wjwpoi/DaisySeedProjects/SeedFX/docs/PROCUREMENT_READINESS.md

# 单台成品：采购前复核

**当前状态：软件与数字工程可构建，采购冻结尚未完成。** 现有装配、开孔和供应商清单需要继续复核，不能把“编译/DRC 通过”视为整机装配与采购均已确认。唯一一台设备在调试验收后作为最终成品。

## 此次查出的明确问题与修正

- 电源口：旧壳体侧孔使用居中 X=33mm，而当前 Rev6 PCB 的 J1 Fabrication 外形轴线为正视 X=42.57mm，旧横向孔位相差 9.57mm。STEP、侧孔 CSV 和布局数据现已按该轴线修正；安装高度 Z=22mm 仍须依据实际器件安装栈核对。
- 音频接口标注：PCB J2 为右侧输入、J4 为左侧输出，侧孔 CSV 已修正；两孔几何尺寸相同。
- 装配 BOM：原表中的 R9-12、R21-25、R26-29 已展开为各个器件编号，增加 Quantity 列。新增检查用导出的 KiCad 网表验证编号存在、无重复、数量一致。
- XIAO 附件包络长边取 21mm、短边修正为 17.8mm。包络检查仍未覆盖供应商实际高度、焊点和线束。

## 可推进的采购工作

| 分组 | 物料/工作 | 当前状态 |
|---|---|---|
| 首轮指定型号模块 | 原厂 Daisy Seed，确认 Rev7 与焊针配置，1 个；Seeed XIAO ESP32-C3，带天线，1 个 | 架构已选定，可准备报价/采购；后续安装在同一台最终成品中 |
| 固定料号外围 | Alpha RD901F-40-15R1-B10K ×6；Bourns PEC11R-4220K-S24 ×1；Neutrik NMJ6HCD2 ×2 | 参考项目明确使用过这些料号；购买时确认完整型号、安装图与库存 |
| 屏幕、脚踏、旋钮、排针、降压板、天线 | 对应采购 BOM 中的规格 | 待具体商品/安装图确认，尤其屏幕排布、排针高度、旋钮孔径、天线外形、降压板高度 |
| 主板与无线适配板制作/装配 | Gerber、装配 BOM、贴片位置 | 数字检查通过；当前偏向自行焊接，仍需复核主板 ERC 注记与装配尺寸；局部代焊作为练习后备选 |
| 通用壳体 / 打印壳与封面 | 淘宝铝壳加孔、或加强 PETG 打印壳；贴纸封面 | 待完整装配栈、天线位置与具体壳体确认；打印壳还需承重结构复核；用户封面尚未提供 |

本轮只准备或购买一台最终成品会使用的零件，不再安排第二台设备。工厂最低订单产生的余板是维修备件，费用全部计入该单台项目。

## 下单前尚需关闭的设计与采购事项

1. **完整装配核对**：为选定的 Seed/排针、插座、屏幕、脚踏和外壳补齐安装尺寸，检查高度、公差、USB 接入口、螺母、线束与 RF 天线。当前 CAD 只检查裸板与附件包络，主控深度≤28mm 是采购假设，尚未以完整元件模型证实。
2. **主板 ERC 注记复核**：报告中有 115 个网格警告、9 个 NC 注记与实际连接不符、1 个悬空线端。其中 A1 的 USART1 TX/RX 现在用于无线，图纸上的 NC 语义需要更新。DRC 与网表一致性通过可以证明铜层连接一致，不能替代对图纸意图的复核。
3. **电源选型与装配方式**：明确具体 Mini-360 商品的尺寸、输入/输出额定条件与调节固定方法。用户没有工具，按 [手焊方案](DIY_BUILD_OPTIONS.md) 计入基础工具与练习耗材；练习后仍可选择只代焊主板贴片。电压、纹波、噪声、过冲和温升在同一台设备组装时实测。
4. **单台完整报价**：当前全手焊加通用铝壳/外包开孔预算 ¥833.9–1801.5，全手焊加打印壳预算 ¥778.9–1636.5，均含新购工具；[逐项委托制作预估](PURCHASING_PRICES.md) 留作历史对照。实际物料最低包装、裸板订单、工具与外壳制作尚未取得完整成交报价；具体壳体安装和打印受力结构也未完成验证。

## 采购后正常进行的实机工作

在这一台设备上测量音质、端到端延迟、回调峰值、换模静音窗口、供电/RF 噪声、保存恢复和长期稳定性，按 VALIDATION.md 记录。确认后的采购尺寸与同一台设备的实际装配复核应在最终加工外壳之前完成。
