wjwpoi/DaisySeedProjects/SeedFX/mechanical/front-drill.csv

Reference | X_mm_from_left | Y_mm_from_top | Through_diameter_mm | Label
POT1 | 13 | 17 | 7.2 | INPUT
POT2 | 33 | 17 | 7.2 | BASS
POT3 | 53 | 17 | 7.2 | MID
POT4 | 13 | 40.5 | 7.2 | TREBLE
POT5 | 33 | 40.5 | 7.2 | LEVEL
POT6 | 53 | 40.5 | 7.2 | USER
ENC1 | 33 | 81.275 | 7.2 | EDIT
LED1 | 15 | 87.5 | 3.2 | ON
LED2 | 51 | 87.5 | 3.2 | CLIP
FS1 | 15 | 106.5 | 12.2 | BYPASS / TUNER
FS2 | 51 | 106.5 | 12.2 | TAP / PRESET
