wjwpoi/DaisySeedProjects/SeedFX/mechanical/accessory-placement.csv

name | x | y | z | width | length | height
radio_adapter | 5 | 55.5 | 29.699999999999996 | 32 | 28 | 7.6
xiao_esp32c3 | 38.5 | 55.5 | 34.3 | 21 | 17.8 | 4
mini360 | 39.5 | 76 | 34.3 | 18 | 14 | 4
