wjwpoi/DaisySeedProjects/SeedFX/docs/images/panel-preview.png

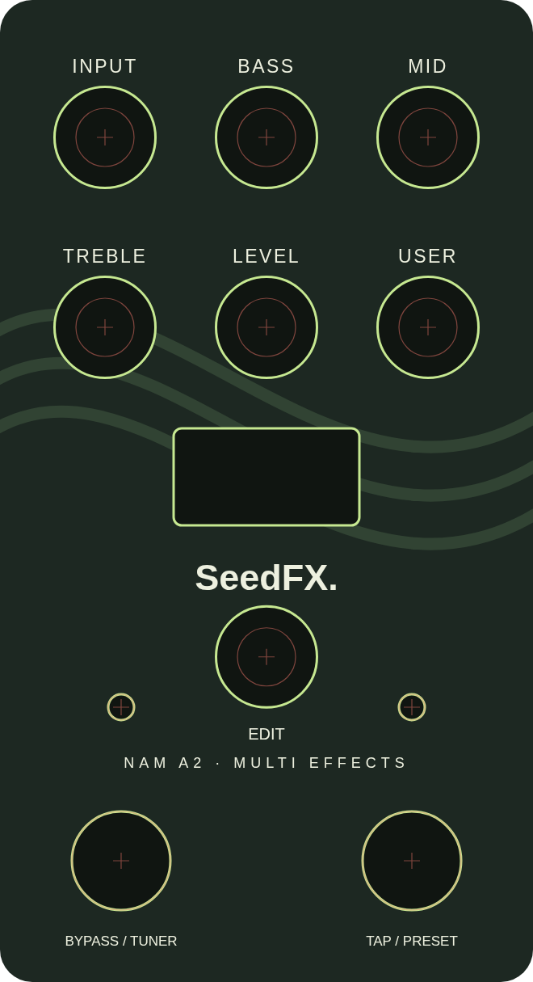
SeedFX/docs/images/panel-preview.png
