wjwpoi/DaisySeedProjects/SeedFX/docs/images/web-desktop.png

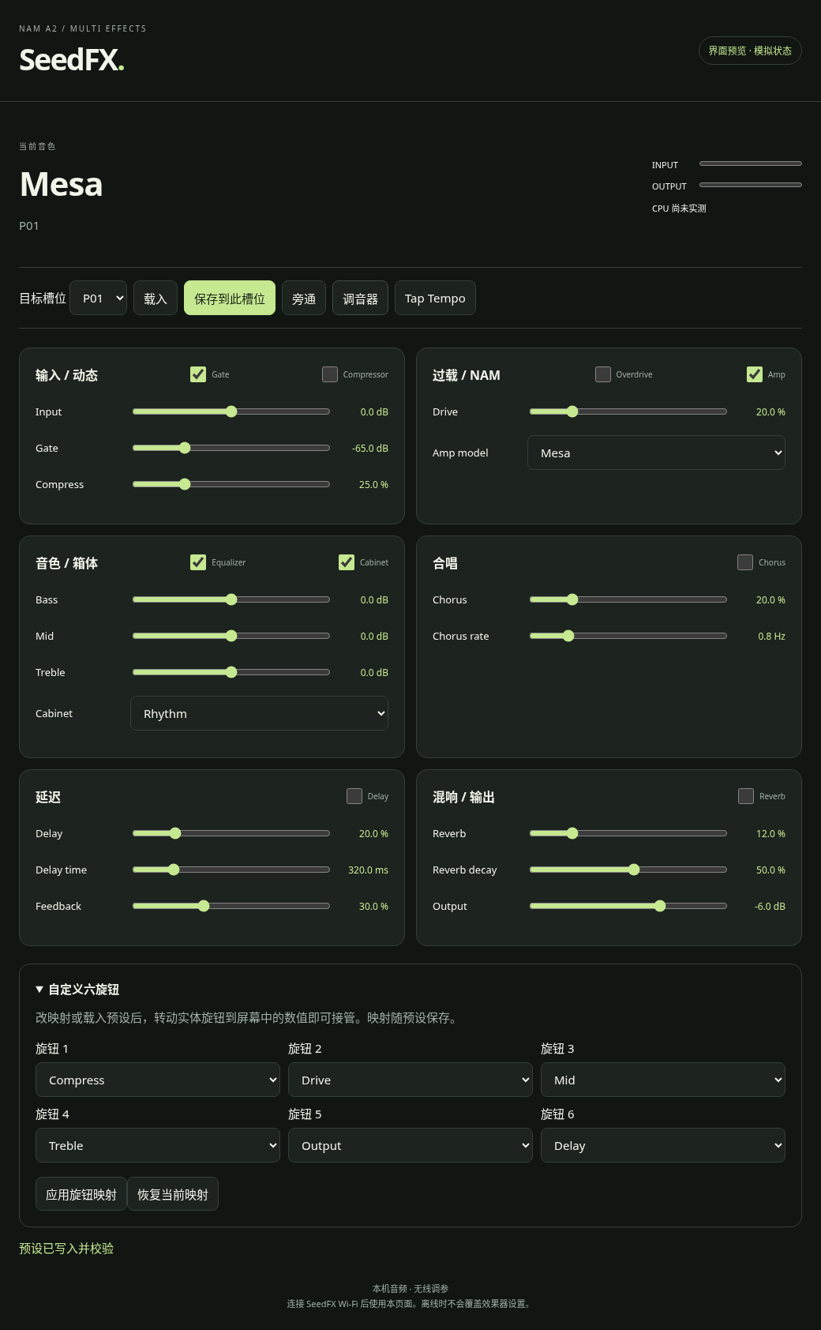
SeedFX/docs/images/web-desktop.png
