wjwpoi/DaisySeedProjects/SeedFX/docs/images/web-mobile.png

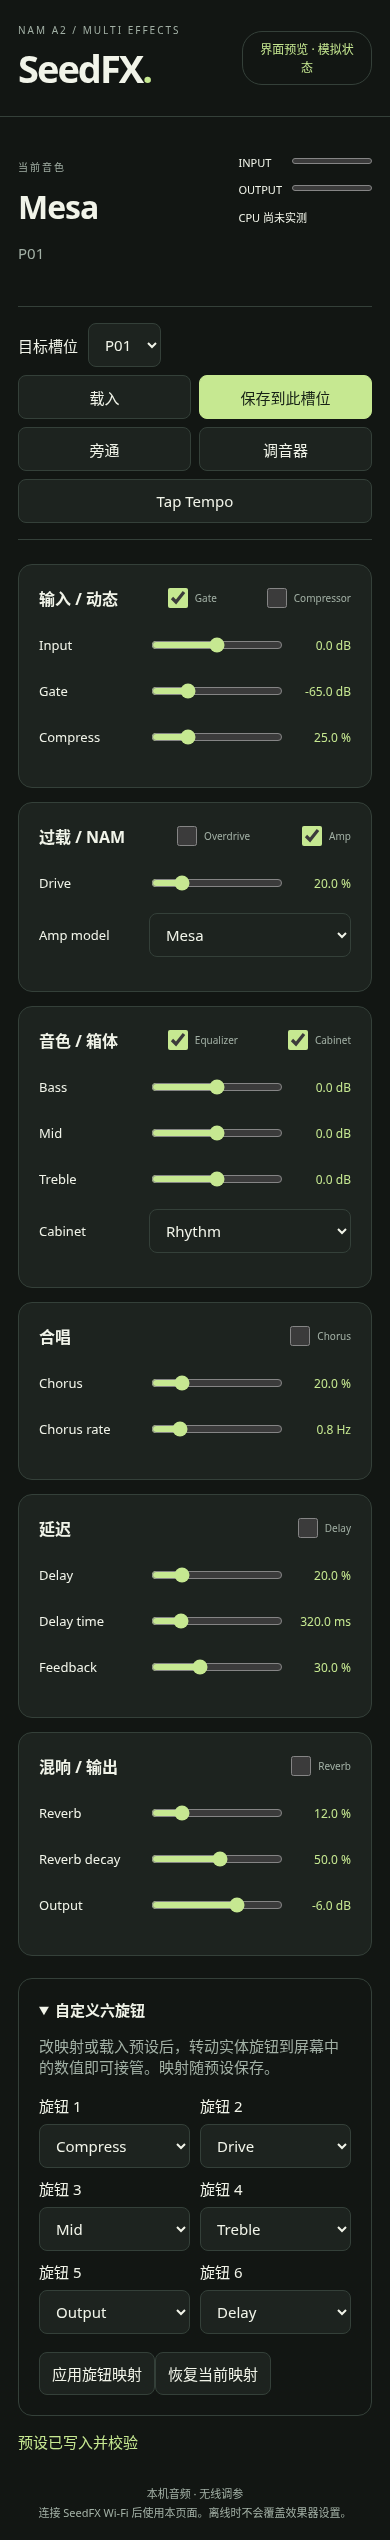
SeedFX/docs/images/web-mobile.png
