wjwpoi/DaisySeedProjects/ToneDock/docs/images/desktop.png

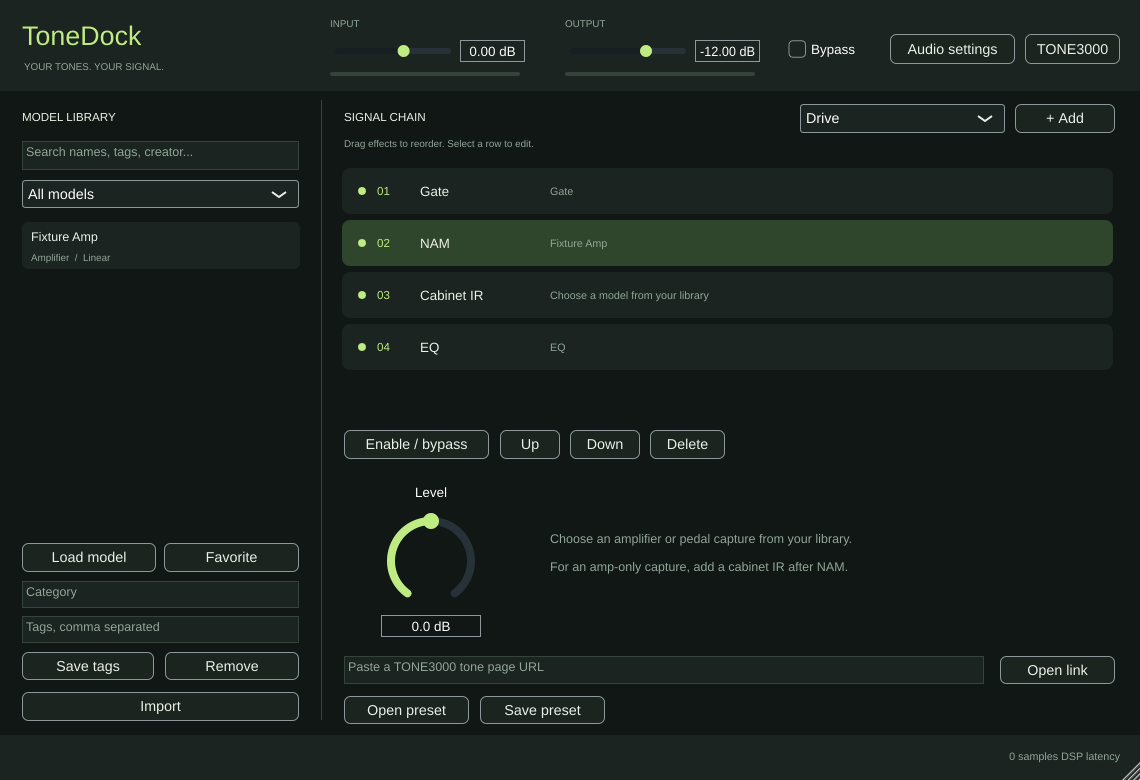
ToneDock/docs/images/desktop.png
