wjwpoi/DaisySeedProjects/SeedFX/docs/PURCHASING_PRICES.md

# 单台采购预估价

金额为人民币工程预算预估，未获取实时店铺价格或服务商报价。采购数量为一台成品所需；裸板按一次最低订单预留费用，余板作为备件。实际最低订单、装配数量和服务费需要询价确认。

**当前制作方向改为自行焊接、通用铝壳或3D打印壳，并计入从零购置工具的费用。** 下表保留此前委托制作的对照报价口径；不应把全表与新路线叠加购买。新路线见 [手焊与通用外壳预算](DIY_BUILD_OPTIONS.md)。

| 项目 | 渠道 | 数量 | 单价预估（元） | 小计预估（元） |
|---|---|---:|---:|---:|
| Daisy Seed 主控 | 淘宝 / 京东 / 原厂代理 | 1个 | 240–360 | 240–360 |
| 主板裸板最低订单 | 嘉立创打板 | 1单 | 20–60 | 20–60 |
| 主板贴片元件一套 | 嘉立创代采 / 立创商城 | 1套 | 65–120 | 65–120 |
| B10K 电位器 | 淘宝 / 立创商城 | 6个 | 4–8 | 24–48 |
| 按压编码器 | 淘宝 / 立创商城 | 1个 | 10–25 | 10–25 |
| 七针 SPI OLED | 淘宝 / 京东 | 1个 | 20–45 | 20–45 |
| Neutrik 音频插座 | 淘宝 / 立创商城 | 2个 | 10–20 | 20–40 |
| 瞬时常开脚踏 | 淘宝 / 立创商城 | 2个 | 8–18 | 16–36 |
| 3mm LED | 淘宝 / 立创商城 | 2个 | 0.2–1 | 0.4–2 |
| 旋钮帽 | 淘宝 / 立创商城 | 7个 | 2–5 | 14–35 |
| Seed 1×20 排母 | 淘宝 / 立创商城 | 2个 | 2–5 | 4–10 |
| XIAO ESP32-C3 含天线 | 淘宝 / 京东 / 原厂代理 | 1个 | 25–50 | 25–50 |
| Mini-360 降压模块 | 淘宝 / 立创商城 | 1个 | 5–15 | 5–15 |
| 适配板裸板最低订单 | 嘉立创打板 | 1单 | 10–30 | 10–30 |
| 适配板六颗贴片元件 | 立创商城 | 1套 | 3–8 | 3–8 |
| 适配板排针 | 淘宝 / 立创商城 | 3个 | 0.5–1.5 | 1.5–4.5 |
| DC-005 电源座 | 淘宝 / 立创商城 | 1个 | 1–3 | 1–3 |
| 外接 9V 电源 | 淘宝 / 京东 | 1个 | 30–80 | 30–80 |
| 标准金属壳含基础涂装 | 淘宝壳体店 | 1个 | 45–90 | 45–90 |
| RF窗口 / 托盘 / 增高圈 | 3D打印服务 | 1套 | 20–60 | 20–60 |
| 单台封面印刷 | UV印刷 / UV DTF服务 | 1次 | 25–60 | 25–60 |
| 线束 / 螺丝 / 绝缘小件 | 淘宝 / 立创商城 | 1套 | 10–25 | 10–25 |

材料与裸板订单预算合计：**¥608.9–1206.5**。

| 服务项目 | 次数 | 小计预估（元） |
|---|---:|---:|
| 主板 SMT / 代焊工费 | 1次 | 100–300 |
| 适配板手工 / 代焊工费 | 1块 | 10–30 |
| 主板通孔件焊接与线束装配 | 1台 | 50–150 |
| 外壳开孔 / 开槽 / RF窗口加工 | 1台 | 60–180 |
| 多平台合计运费 | 1项目 | 20–60 |
| 小料最小包装 / 采购补差 | 1项目 | 0–80 |

服务与采购附加预算合计：**¥240–800**。
按委托焊接、现成壳体加工路线，单台整项目预算约 **¥848.9–2006.5**。这不是供应商已确认的成交报价或价格上限。

- 主板贴片元件费与贴装工费分开，电源座、音频插座和 Seed 排母单独列价。如果工厂报价已包含它们，从网购清单中删除对应项。
- 适配板裸板、六颗贴片件、三个排针及焊接服务分开，避免打板和小料混计。
- 若代焊报价已经包含通孔件和线束装配，合并工费；自行焊接可去掉对应人工额度，工具采购不在本预算内。
- 主板材料按一个安装套数估算；SMT平台若要求多装板，需要按其整单数量重算费用。
- 小料最小包装补差与裸板最低订单分别核算；目前没有把起步费分摊给第二台机器。
- 单台封面印刷预算为一次UV印刷或UV DTF转印，不同时计算两种工艺。
- 外壳开孔、RF窗口、模块安装尺寸及所有待确认料号仍按 [采购前复核](PROCUREMENT_READINESS.md) 关闭后下单。

明细：[材料 CSV](../hardware/purchase-bom.csv)、[服务 CSV](../hardware/service-budget.csv)、[机器预算](../hardware/cost-plan.json)。

相对原仓库的新增与沿用费用见 [成本来源对比](COST_COMPARISON.md)。当前分项外包预算不能作为原作者造价或商家报价。
