wjwpoi/DaisySeedProjects/SeedFX/hardware/mainboard/assembly-bom.csv

Comment | Designator | Footprint | LCSC_part | Populate_SeedFX | Quantity
10uF | C1,C11,C12,C15,C16,C4,C7,C8 | 805 | C15850 | yes | 8
100nF | C13,C14,C2,C3,C5,C6 | 805 | C49678 | yes | 6
100nF | C17 | 805 | C49678 | DNP | 1
2.2nF | C10,C9 | 805 | C28260 | yes | 2
10nF | C18,C19 | 805 | C1710 | yes | 2
1N5817 | D1 | SOD-123 | C727113 | yes | 1
1N4148W | D2 | SOD-123 | C81598 | DNP | 1
1N4007W | D3,D4 | SOD-123FL | C108803 | yes | 2
DC-005-2.5A-2.0 | J1 |  | C136744 | yes | 1
NMJ6HCD2 | J2,J4 |  | C368502 | yes | 2
PJ-320A | J3,J5 |  | C2884926 | DNP | 2
1x20 Through Hole Header | J6,J7 |  | C50984 | yes | 2
G6K-2G-Y DC5 | K1,K2 | SMD,6.5x10mm | C397140 | yes | 2
SS8050 | Q1 | SOT-23-3 | C2150 | yes | 1
2M | R1,R10,R11,R12,R15,R16,R2,R4,R5,R9 | 805 | C26112 | yes | 10
100K | R3,R6 | 805 | C149504 | yes | 2
100R | R13,R14 | 805 | C17408 | yes | 2
220R | R17 | 805 | C17557 | DNP | 1
33R | R19 | 805 | C17634 | DNP | 1
10R | R18 | 805 | C17415 | DNP | 1
470R | R20 | 805 | C17710 | DNP | 1
1K | R21,R22,R23,R24,R25 | 805 | C17513 | yes | 5
3.3K | R7,R8 | 805 | C26010 | yes | 2
10K | R26,R27,R28,R29 | 805 | C17414 | yes | 4
LD1117S50CTR | U1 | SOT-223-3 | C81157 | yes | 1
MCP6004T-I/SL | U2 | SOIC-14 | C7378 | yes | 1
OPA1652AIDR | U3 | SOIC-8 | C30025 | yes | 1
H11L1 | U4 | SOP-6-2.54mm | C78589 | DNP | 1
CPC1018N | U5,U6 | SOP-4-2.54mm | C133069 | yes | 2
