wjwpoi/DaisySeedProjects/SeedFX/mechanical/mainboard.step

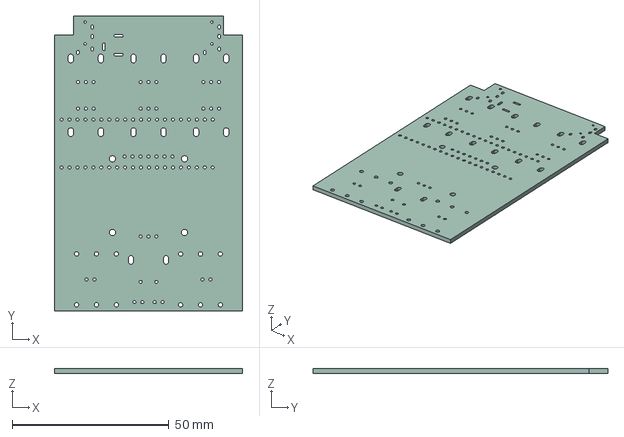
[picture p5: CAD file, 2026-10-14]
SeedFX/mechanical/mainboard.step
60.0 x 94.0 x 1.52 mm
