wjwpoi/DaisySeedProjects/SeedFX/mechanical/seedfx-case.step

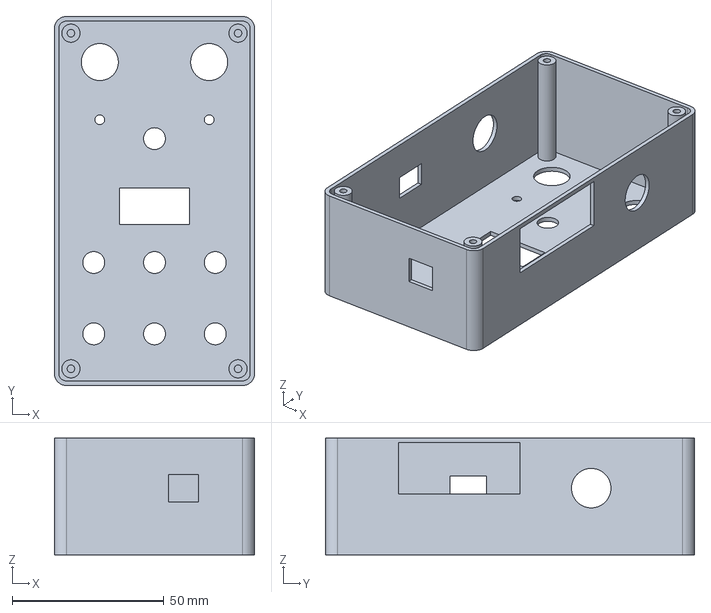
[picture p6: CAD file, 2026-10-14]
SeedFX/mechanical/seedfx-case.step
66.0 x 121.5 x 38.5 mm
