wjwpoi/DaisySeedProjects/SeedFX/mechanical/front-drill.dxf

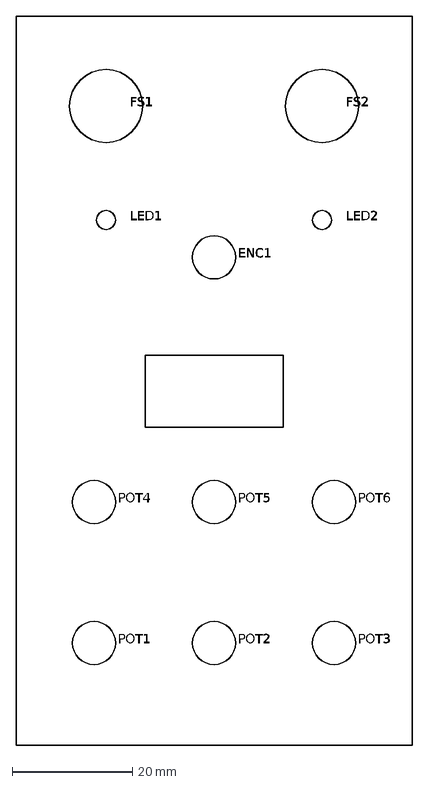
[picture p7: CAD file, 2026-10-14]
SeedFX/mechanical/front-drill.dxf
POT1
POT2
POT3
POT4
POT5
POT6
ENC1
LED1
LED2
FS1
FS2
