wjwpoi/DaisySeedProjects/SeedFX/mechanical/seedfx-insulating-tray.step

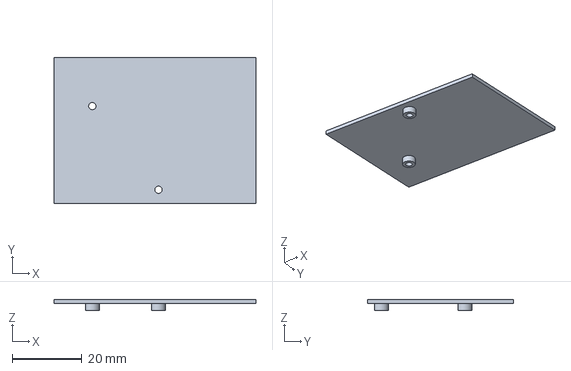
[picture p8: CAD file, 2026-10-14]
SeedFX/mechanical/seedfx-insulating-tray.step
58.0 x 42.0 x 3.20 mm
