wjwpoi/DaisySeedProjects/SeedFX/mechanical/seedfx-lid.step

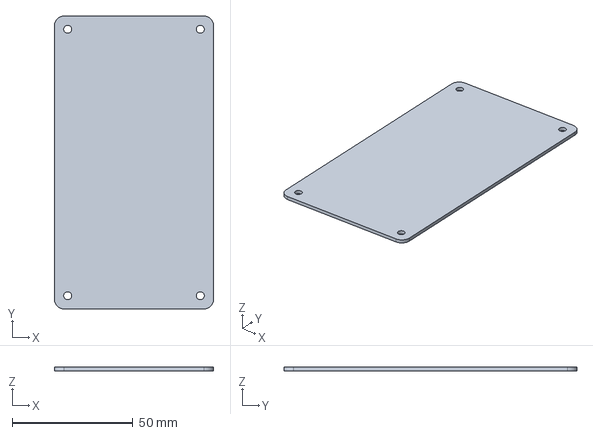
[picture p9: CAD file, 2026-10-14]
SeedFX/mechanical/seedfx-lid.step
66.0 x 121.5 x 1.50 mm
