wjwpoi/DaisySeedProjects/SeedFX/mechanical/seedfx-enclosure.step

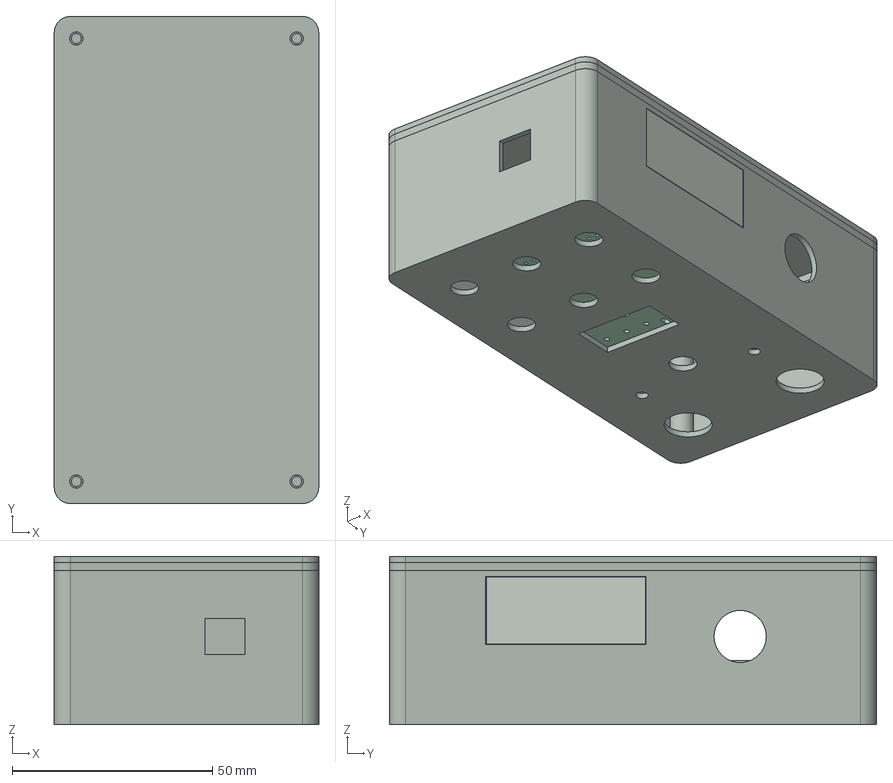
[picture p10: CAD file, 2026-10-14]
SeedFX/mechanical/seedfx-enclosure.step
66.0 x 121.5 x 42.0 mm
lid_spacer_part
insulating_tray_part
radio_window_part
case_part
lid_part
mainboard_body_part
radio_adapter_envelope_part
xiao_esp32c3_envelope_part
mini360_envelope_part
