wjwpoi/DaisySeedProjects/SeedFX/mechanical/seedfx-lid-spacer.step

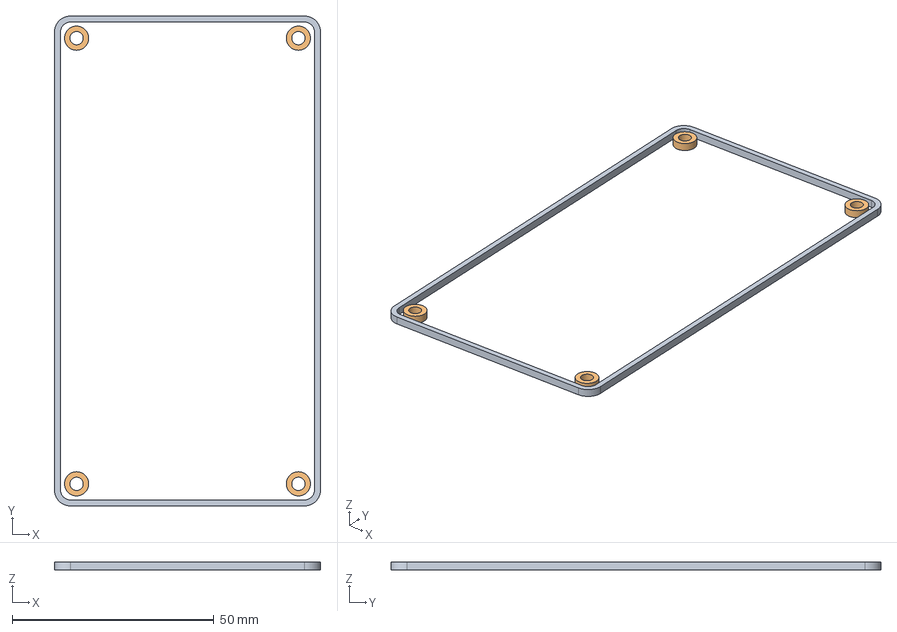
[picture p11: CAD file, 2026-10-14]
SeedFX/mechanical/seedfx-lid-spacer.step
66.0 x 121.5 x 2.00 mm
