wjwpoi/DaisySeedProjects/SeedFX/mechanical/seedfx-rf-window.step

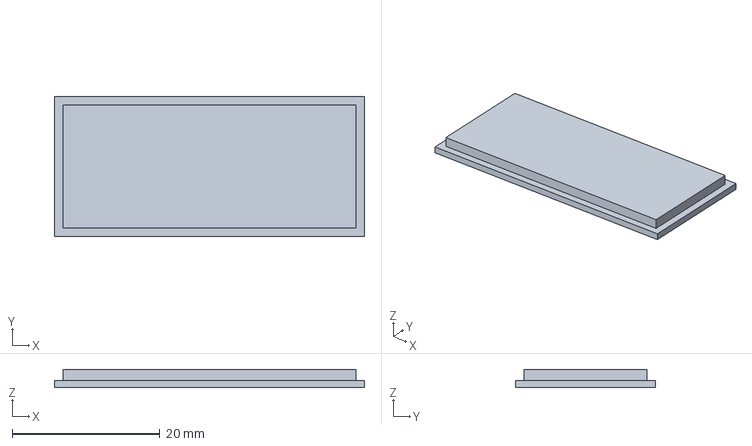
[picture p12: CAD file, 2026-10-14]
SeedFX/mechanical/seedfx-rf-window.step
42.0 x 19.0 x 2.50 mm
