wjwpoi/DaisySeedProjects/(list of files, cad)

Other CAD files:
SeedFX/mechanical/seedfx-case.stl
SeedFX/mechanical/seedfx-insulating-tray.stl
SeedFX/mechanical/seedfx-lid-spacer.stl
SeedFX/mechanical/seedfx-lid.stl
SeedFX/mechanical/seedfx-rf-window.stl
