wjwpoi/DaisySeedProjects/SeedFX/docs/VALIDATION.md

# 验证记录与实机验收

## 数字检查

当前执行结果由 `docs/validation.json` 汇总，构建产物及文件 SHA256 在发布包 manifest 中。

| 检查 | 范围与结果 |
|---|---|
| Daisy 交叉编译 | Cortex-M7、hard-float、BOOT_SRAM；ELF/HEX/BIN 生成；链接内存未溢出 |
| ESP32-C3 交叉编译 | ESP-IDF v5.4.2；网页嵌入；生成 bootloader、分区表和应用；分区容量检查通过 |
| 协议 | CRC32 标准向量、500 组随机帧、损坏拒绝、溢出恢复、SPSC 队列边界 |
| 音频与控制 | 真实 NAM 推理、五模型全效果链有限/有界输出、IR 响应与延迟回声检查、参数边界、旋钮慢速转动/拾取、配置淡出/暂停、预设 CRC 和失败恢复逻辑 |
| 快速初始化 | 原始 133 块预热对比五个模型的解析稳态；15,360 个样本，当前最大绝对误差约 8.64e-7 |
| 模型校验 | 有效固定结构；拒绝错误权重数、NaN、同数目错结构、错误激活和 44.1kHz |
| 网页逻辑 | 参数、模型整数、预设和映射范围；错误/离线请求不会报成功 |
| 浏览器 | 实际 Chromium；模型选择、多旋钮草稿、写入确认等待、调音读数、390px 布局、失联禁用；数据为明确标注的测试夹具 |
| PCB | 两块板 DRC 无违规、无未连接项、无网表一致性问题；适配板 ERC 无违规 |
| 主板 ERC | 没有错误；保留参考图纸 115 项 off-grid、9 项已连接 NC 标记和1项线端警告。主板实际铜层网表一致性与连接检查通过；报告完整保留，不以隐藏警告代替检查 |
| 机械 | 裸主板与壳体实体干涉为零；附件包络与主板/壳体/后盖及附件间无重叠；主控深度需≤28mm，附件按采购包络限制；不覆盖实际器件高度、公差和线束 |

本机运行的测试不是硬件在环测试。主机 CPU 上的耗时不能作为 STM32 的回调耗时，浏览器测试夹具不证明实物无线工作。没有执行 USB 烧录、吉他试听、模拟电路测量或 RF/温升测试。

## 唯一一台设备的成品验收表

| 项目 | 方法与判定 |
|---|---|
| 电源 | 接主控前检查极性/短路；9V 输入，标定 5V；0–0.5A 负载、开关机和瞬态检查；无越过 MCU 允许范围的电压 |
| 旋钮与数字输入 | 六 ADC 全行程、编码器两个方向/按压、两脚踏长短按；确认没有支脚碰到 Seed 针座 |
| 屏幕 | SSD1306 SPI、列/行完整、开孔不遮活动区、字号与户外可读性 |
| 音频电平 | 1kHz 已知电压信号测输入满量程与输出；确认 codec 前不过载，旁通与启用响度可控制 |
| 延迟 | 用环回录音测 NAM/EQ/IR 路径；记录首次响应和峰值/群延迟，目标小于5ms |
| 实时预算 | 所有效果、各模型、最大反馈、屏幕刷新及 Wi-Fi 连续调参；回调最大耗时低于1ms，目标留25%余量，无丢块 |
| 换模 | 五模型至少100次切换，记录静音窗口及是否有明显爆音；目标小于20ms，不能用解析初始化主机测试代替 |
| 同模型预设 | 比较声音、旋钮拾取、启停与尾音；连续参数更新不重载权重 |
| 保存与断电 | 两银行轮换；写入过程中断电后恢复旧有效或新完整银行；保留至少一个有效配置；验证重启槽位 |
| 调音 | E2–E4 六弦与单音，A4=440；目标稳定状态±5 cents，避免泛音倍频误判 |
| 无线与噪声 | 天线装入实际壳体后，5m连接与重连；Wi-Fi开/关录音对比，检查电源和RF串入的噪声 |
| 长时间运行 | 至少60分钟最坏链路，记录温升、供电电流、重连、CPU峰值及音频异常 |
| 机械 | 原料壳与实际器件核尺寸；盖合、螺母、螺柱、焊点、USB口、线束、绝缘及跌落后的固定情况 |

在这唯一一台设备上完成组装、测量、修正和验收。若实测不满足设计指标，按记录修改具体 DSP、供电、天线或结构；达到验收目标后，该设备即为最终成品。
