wjwpoi/DaisySeedProjects/ToneDock/docs/VALIDATION.md

# 验证状态

2026-10-15，北京时间。当前为开发版，**尚未标记为可发布版本**。

| 项目 | 结果 |
|---|---|
| Linux 云端原生编译 | 独立软件与 Linux VST3 构建通过 |
| 自动化测试 | 1 个套件通过，49,860 项检查，含真实编辑器操作 |
| NAM 对照 | LSTM、WaveNet、A2、A1 Standard 与固定提交的官方运行时对照，测试样本最大误差均为0 |
| 宿主采样率转换 | 44.1 / 96 kHz、1 / 17 / 64 / 257 / 511 样本缓冲检查通过 |
| 模型库 | 元数据分类、SHA去重、保存、并发写入、ZIP导入、坏文件/越界ZIP拒绝通过 |
| 实际音频处理器 | Gain → NAM → 输出增益的信号计算、宿主旁通与预设恢复通过 |
| 原生编辑器 | 旋钮、添加、旁通、上移、拖拽、删除检查通过；保存实际组件截图 |
| 独立软件启动 | Xvfb内启动、生成原生编辑器PNG、正常退出通过 |
| 云环境复用脚本 | 安装/配置、重复执行、构建和测试通过 |
| macOS开发归档 | 真实macOS流水线完成归档与上传；Linux夹具的解压检查确认可执行权限和符号链接得到保留 |
| AU注册等待脚本 | 模拟工具检查：延迟发现、超时、仅执行一次完整校验、校验错误退出码保留；不替代真实AU结果 |
| Windows | `4283c77` 独立软件/VST3原生构建、核心测试和开发包上传通过；真实DAW与声卡验收未执行 |
| macOS | `4283c77` Universal独立软件/VST3/AU构建、核心测试、完整AU校验和开发包上传通过；执行环境为macos-14 arm64，Intel运行验收未执行 |
| TONE3000 真实账号 | 未执行；依据官方接入代码完成适配，实际公钥、浏览器授权和下载待联调 |
| 声卡 / DAW 实测 | 未执行；不以云端DSP检查承诺实际端到端延迟或最低可用缓冲 |
| 发行安装包 / 发行签名 / 公证 | 未执行 |

截图 [desktop.png](images/desktop.png) 来自实际JUCE编辑器与自行生成的 Linear 测试模型，不是TONE3000在线浏览或真实音色试听。模型对照只证明这些测试输入与同版本运行时一致，不代表所有架构/模型、所有系统均完成兼容性验收。

结构变化会重建图并交叉淡化，效果尾音不保证完整延续；模型计算量和短时双图渲染仍可能超过特定设备CPU预算。每个效果的完整宿主自动化、第三方插件承载和移动端不在本版范围。

机器记录见 [validation.json](validation.json)，原始输出见 [核心测试](validation/core-tests.log) 与 [独立软件运行日志](validation/standalone.log)。

原生检查与开发包下载见 [GitHub Actions](https://github.com/wjwpoi/DaisySeedProjects/actions/runs/38723754252)。Windows与macOS均完成该轮检查；这些结果不代替真实DAW、声卡或账号联调。

AU安装后先签名验证并刷新注册服务，等待系统枚举出 `aufx / Tnd1 / Tndk` 后，再执行一次完整 `auval -v aufx Tnd1 Tndk`；超时和校验错误均保留为失败。首轮的名称读取、版本 `-50` 与组件未找到错误发生于发现阶段；加入注册就绪等待的用户目录版本已实际通过。最终工作流与该成功版本一致。
