wjwpoi/DaisySeedProjects/SeedFX/hardware/manufacturing/mainboard/schematic.pdf

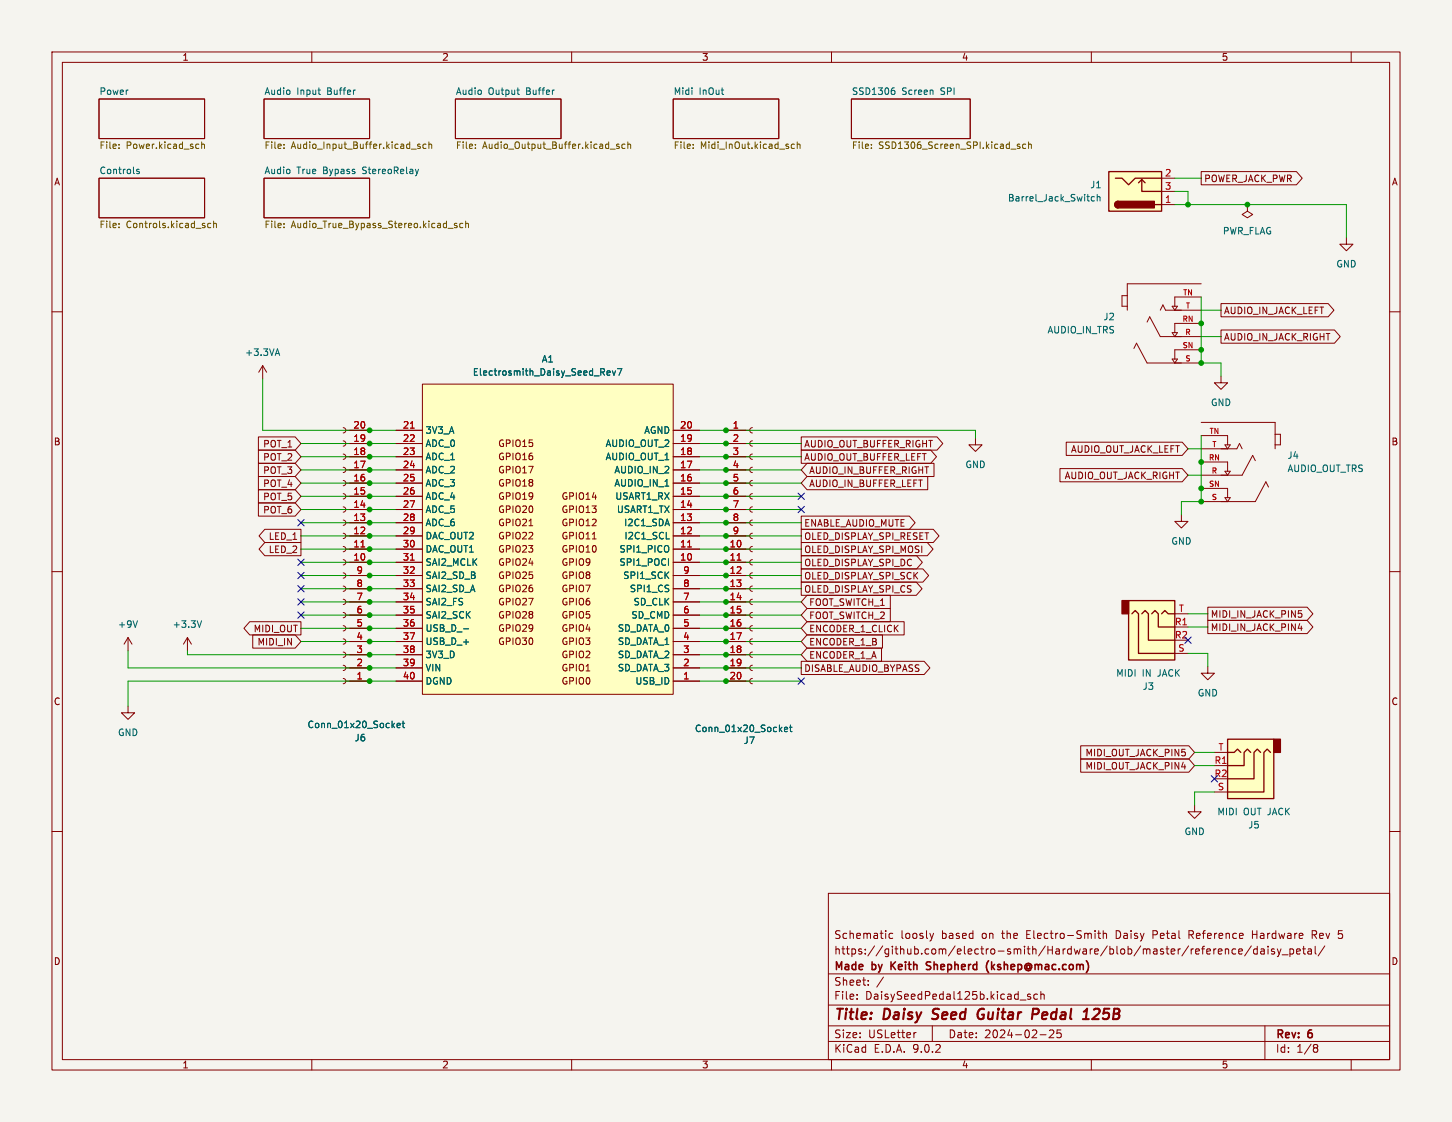
[picture p13: page 1]

Id: 1/8 Title: Daisy Seed Guitar Pedal 125B

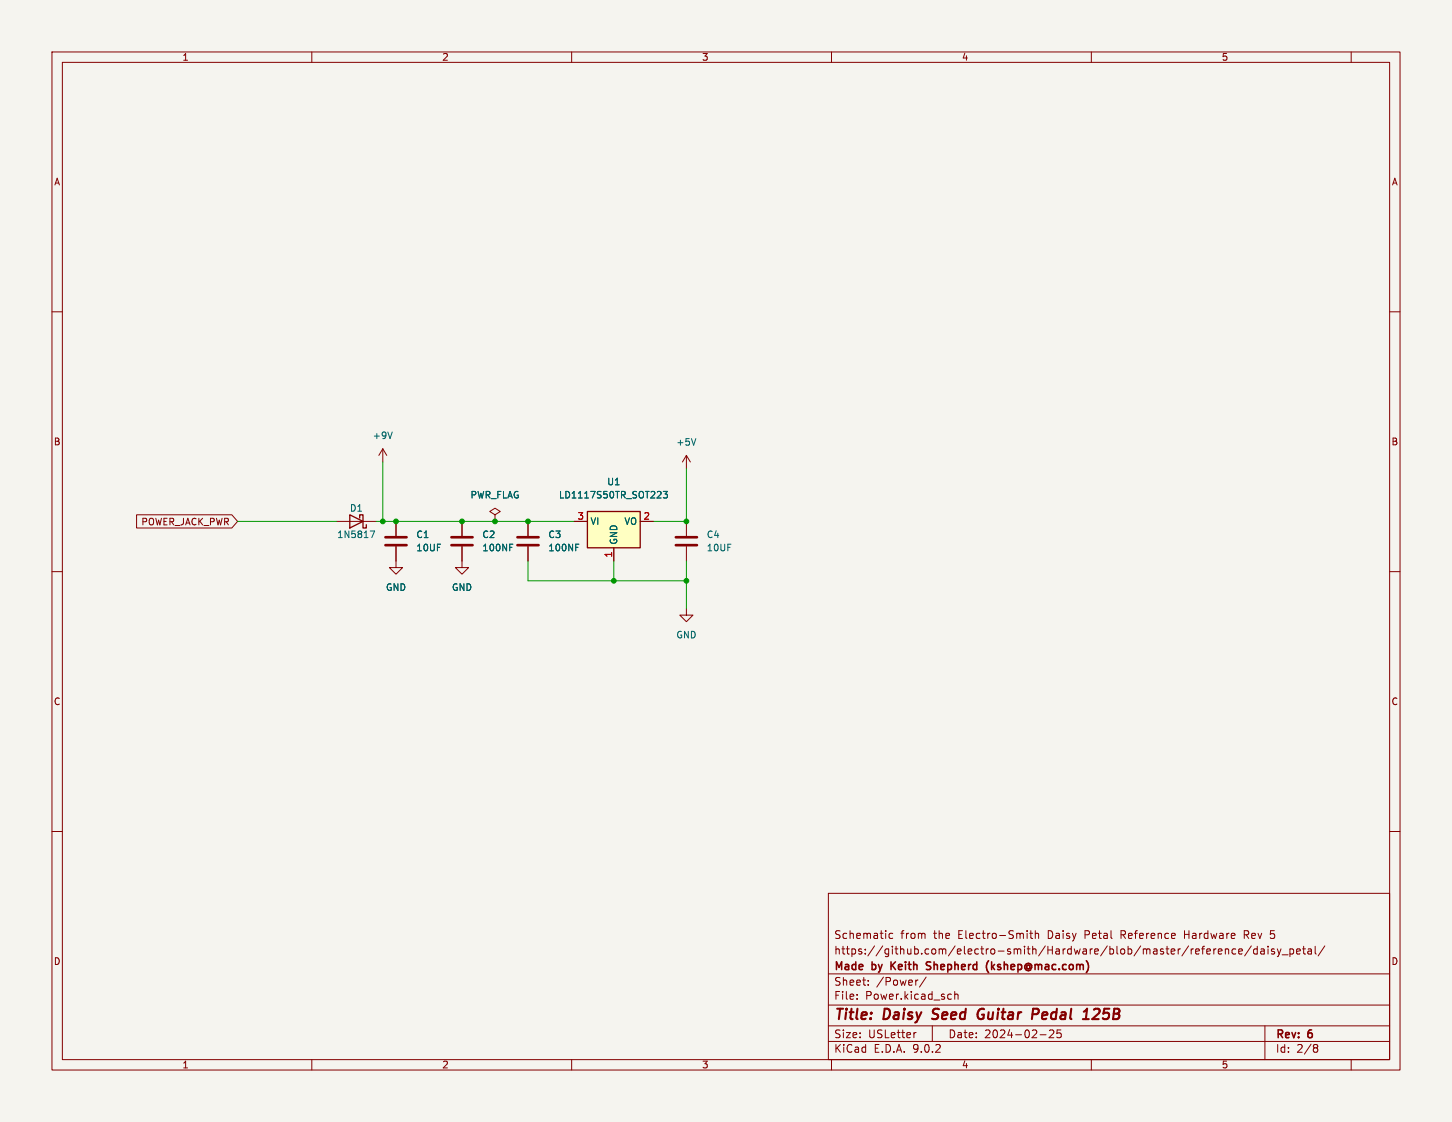
[picture p14: page 2]

Id: 2/8 Title: Daisy Seed Guitar Pedal 125B

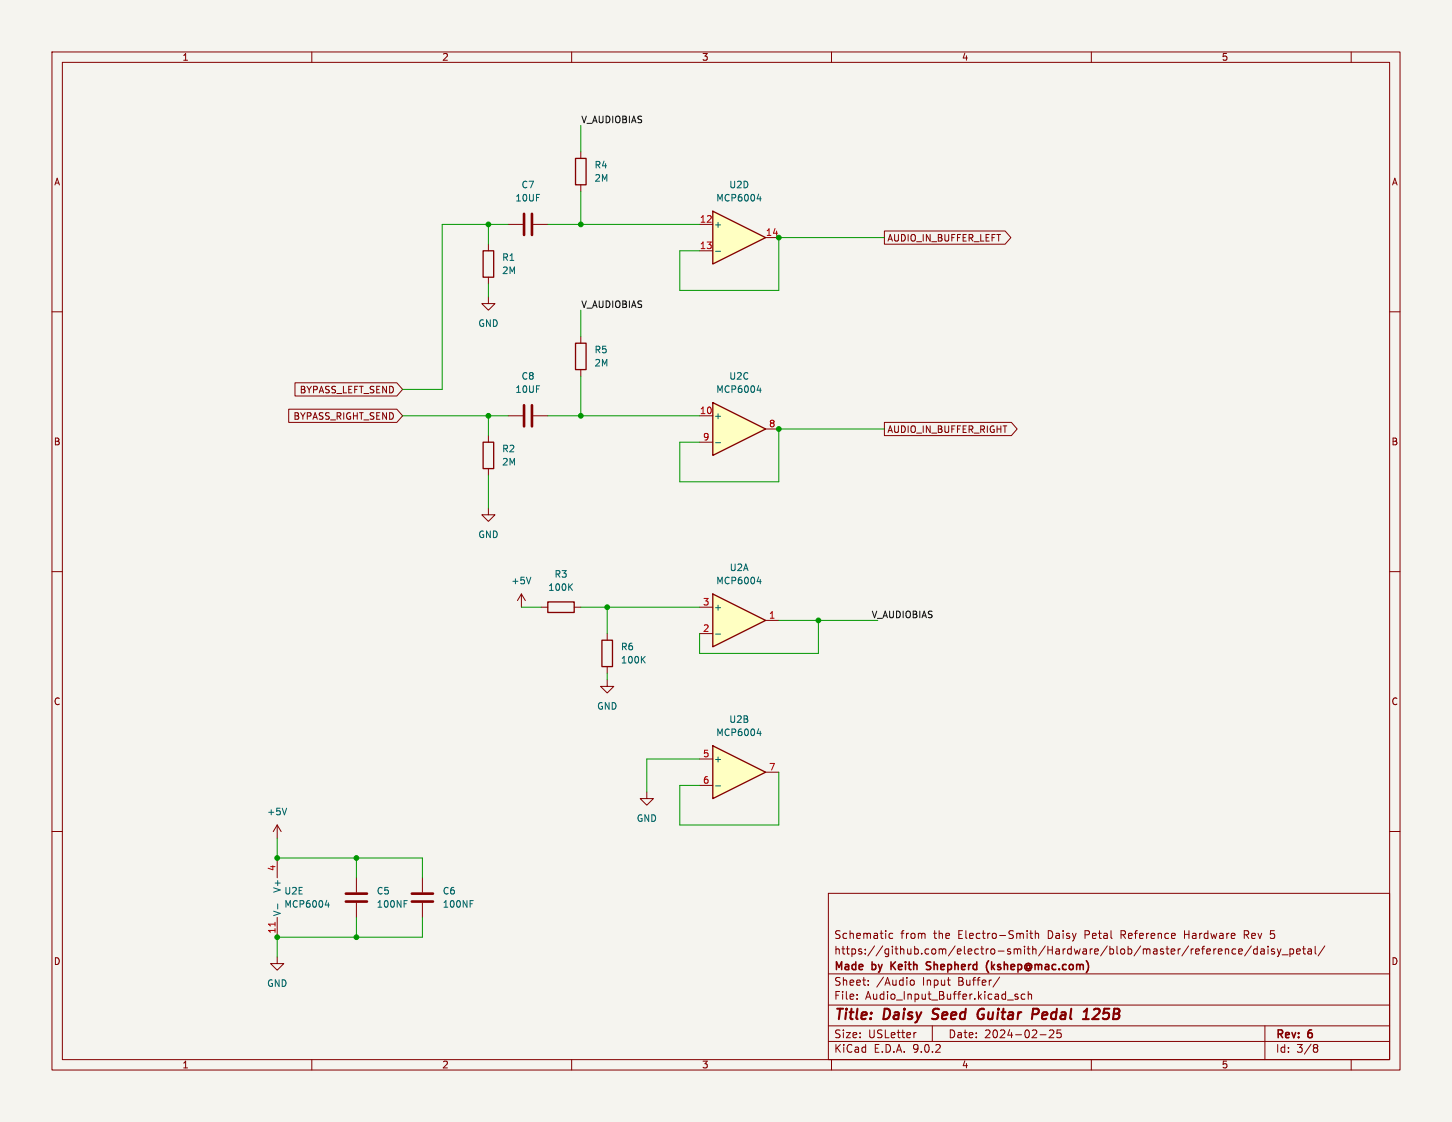
[picture p15: page 3]

Id: 3/8 Title: Daisy Seed Guitar Pedal 125B

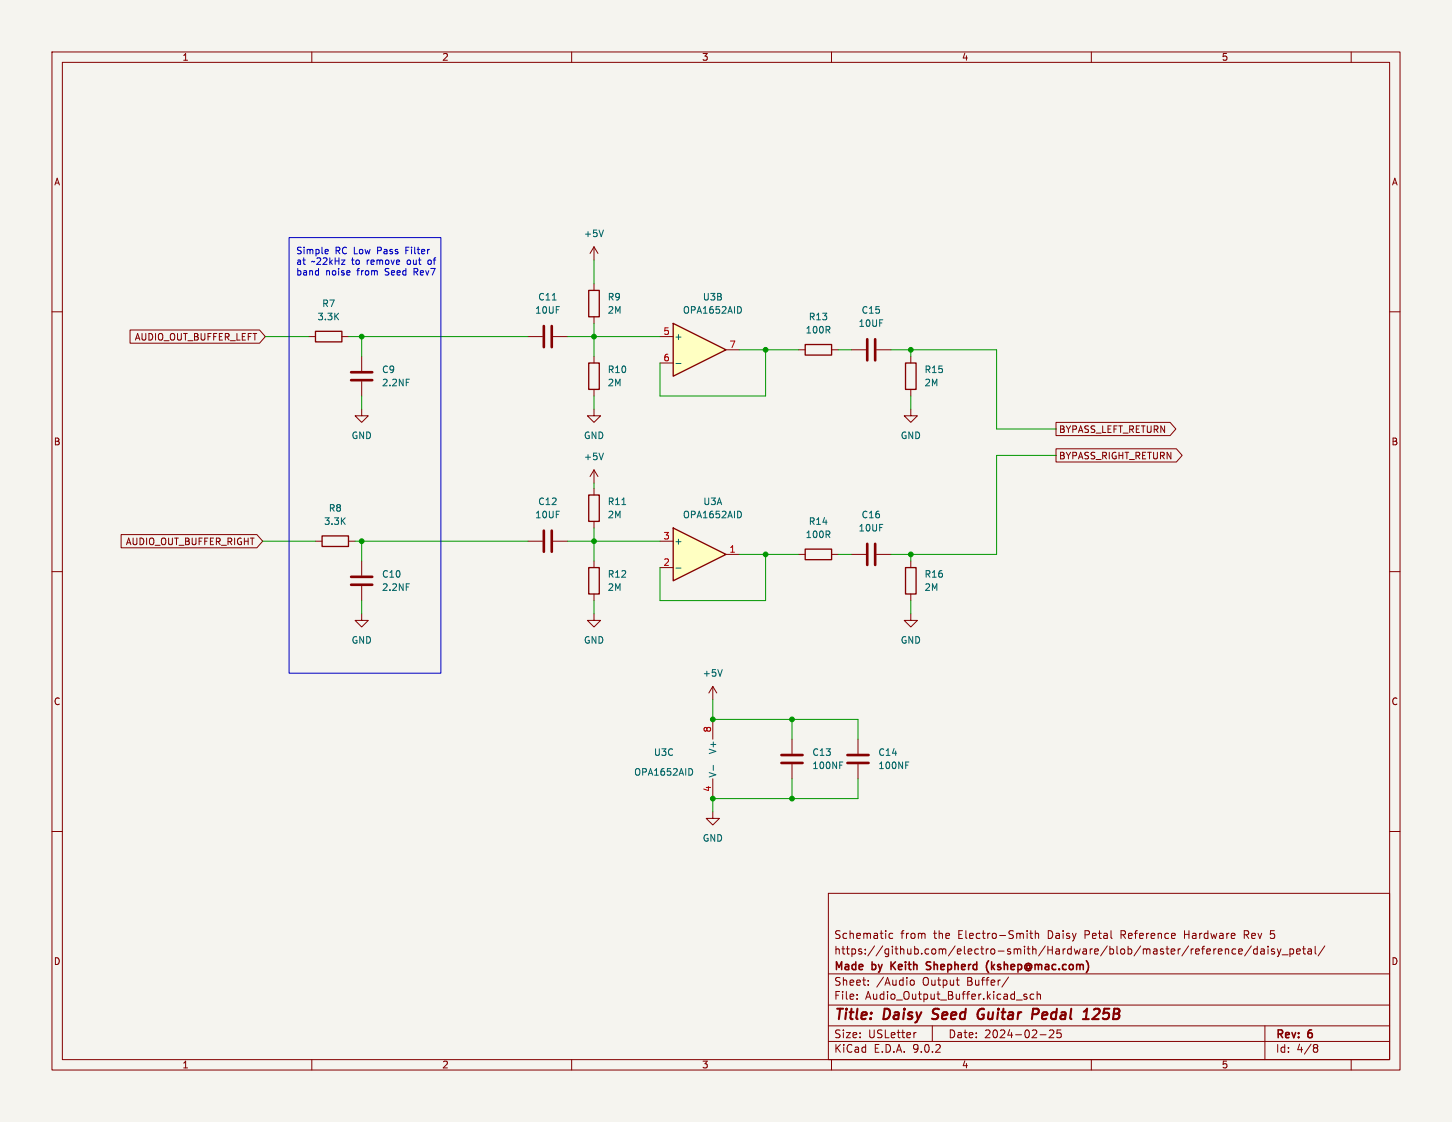
[picture p16: page 4]

https://github.com/electro-smith/Hardware/blob/master/reference/daisy_petal/ Schematic | from the | | Electro-Smith | Daisy | Petal | Reference | Hardware | Rev 5

E.D.A. 9.0.2 Size: USLetter | Rev: 6 | D Date: 2024-02-25 KiCad

Id: 4/8 Title: Daisy Seed Guitar Pedal 125B

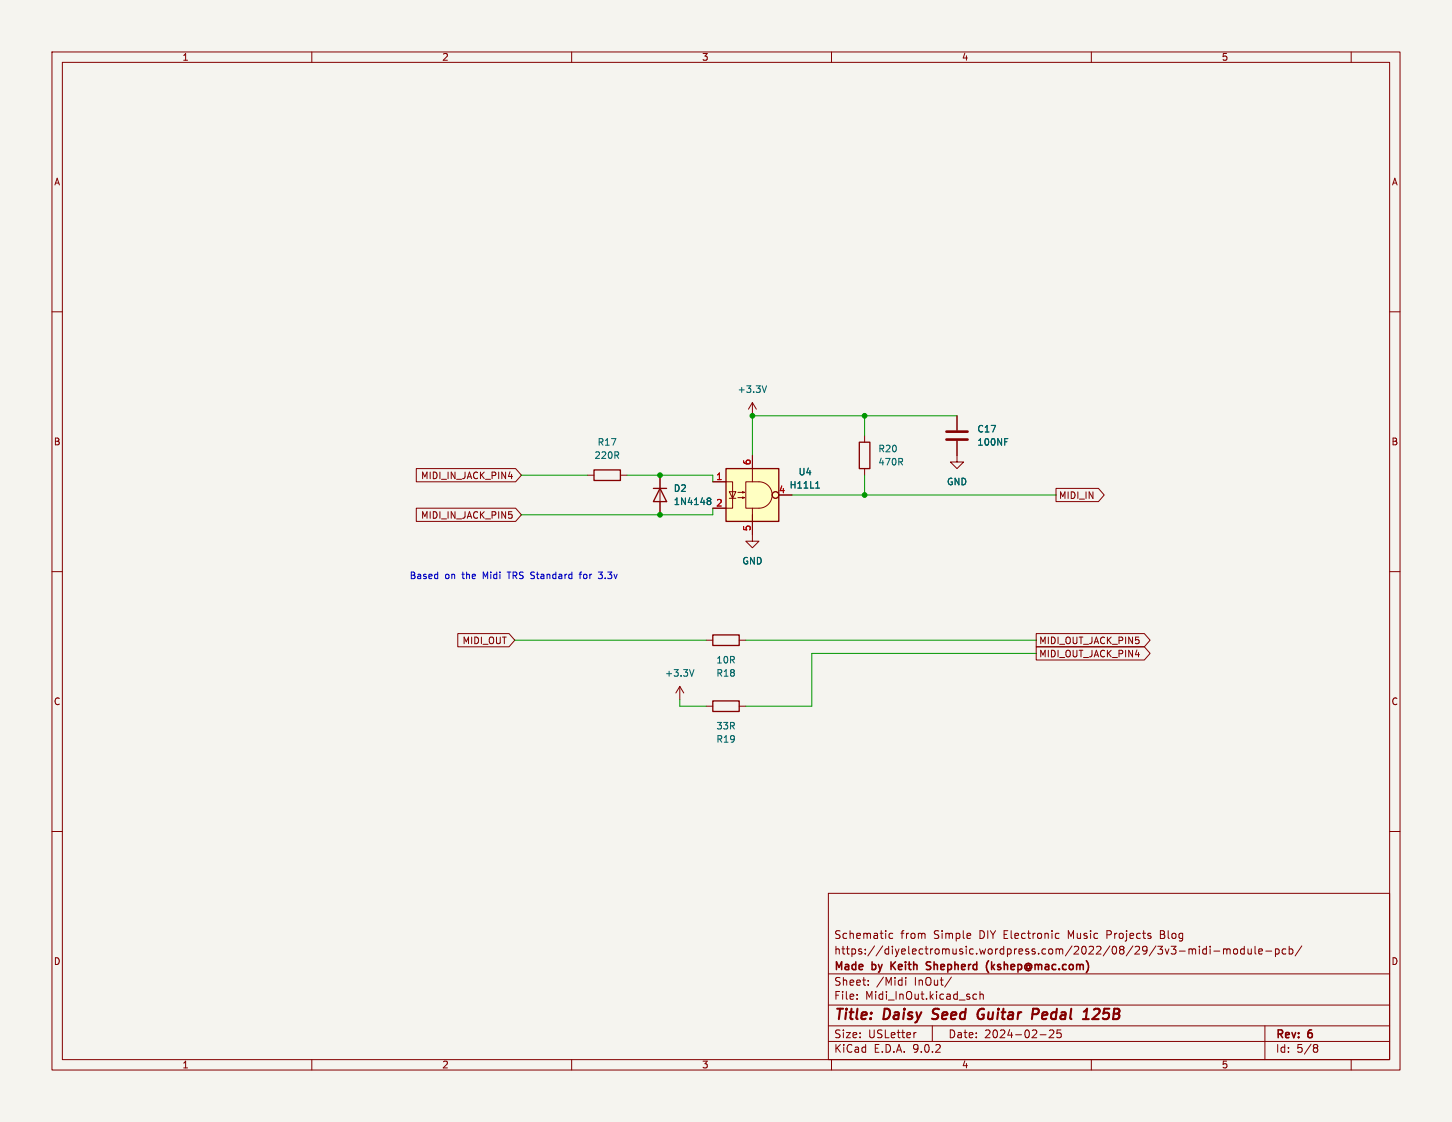
[picture p17: page 5]

Id: 5/8 Title: Daisy Seed Guitar Pedal 125B

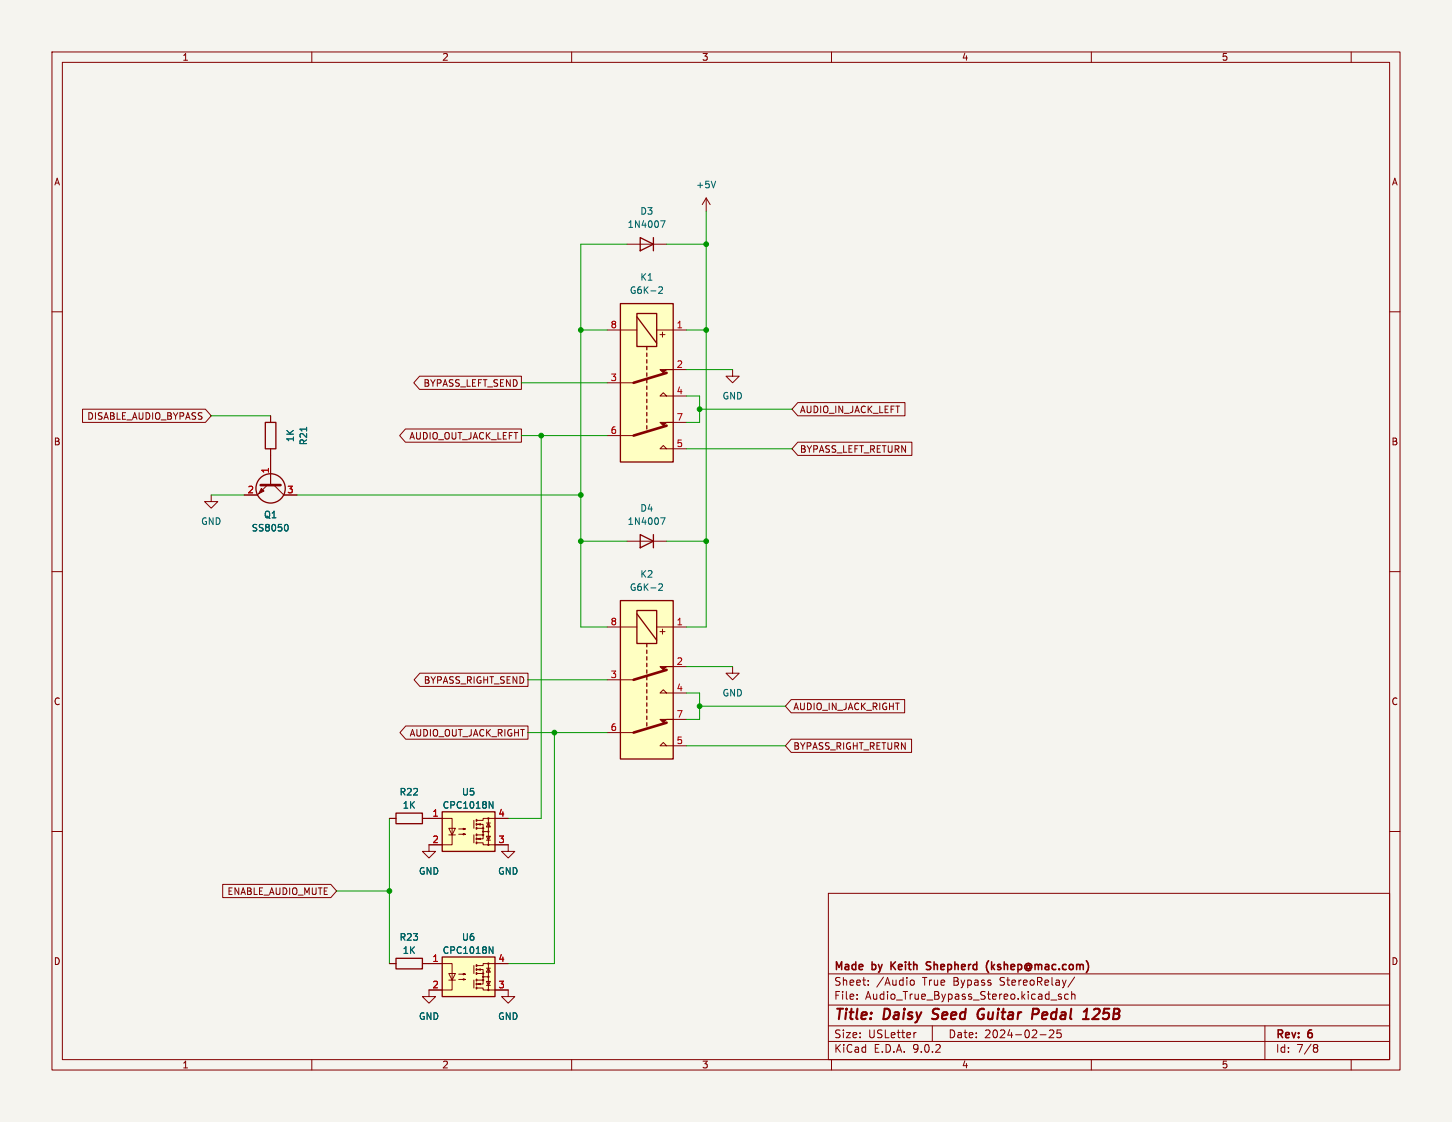
[picture p18: page 6]

Id: 7/8 Title: Daisy Seed Guitar Pedal 125B

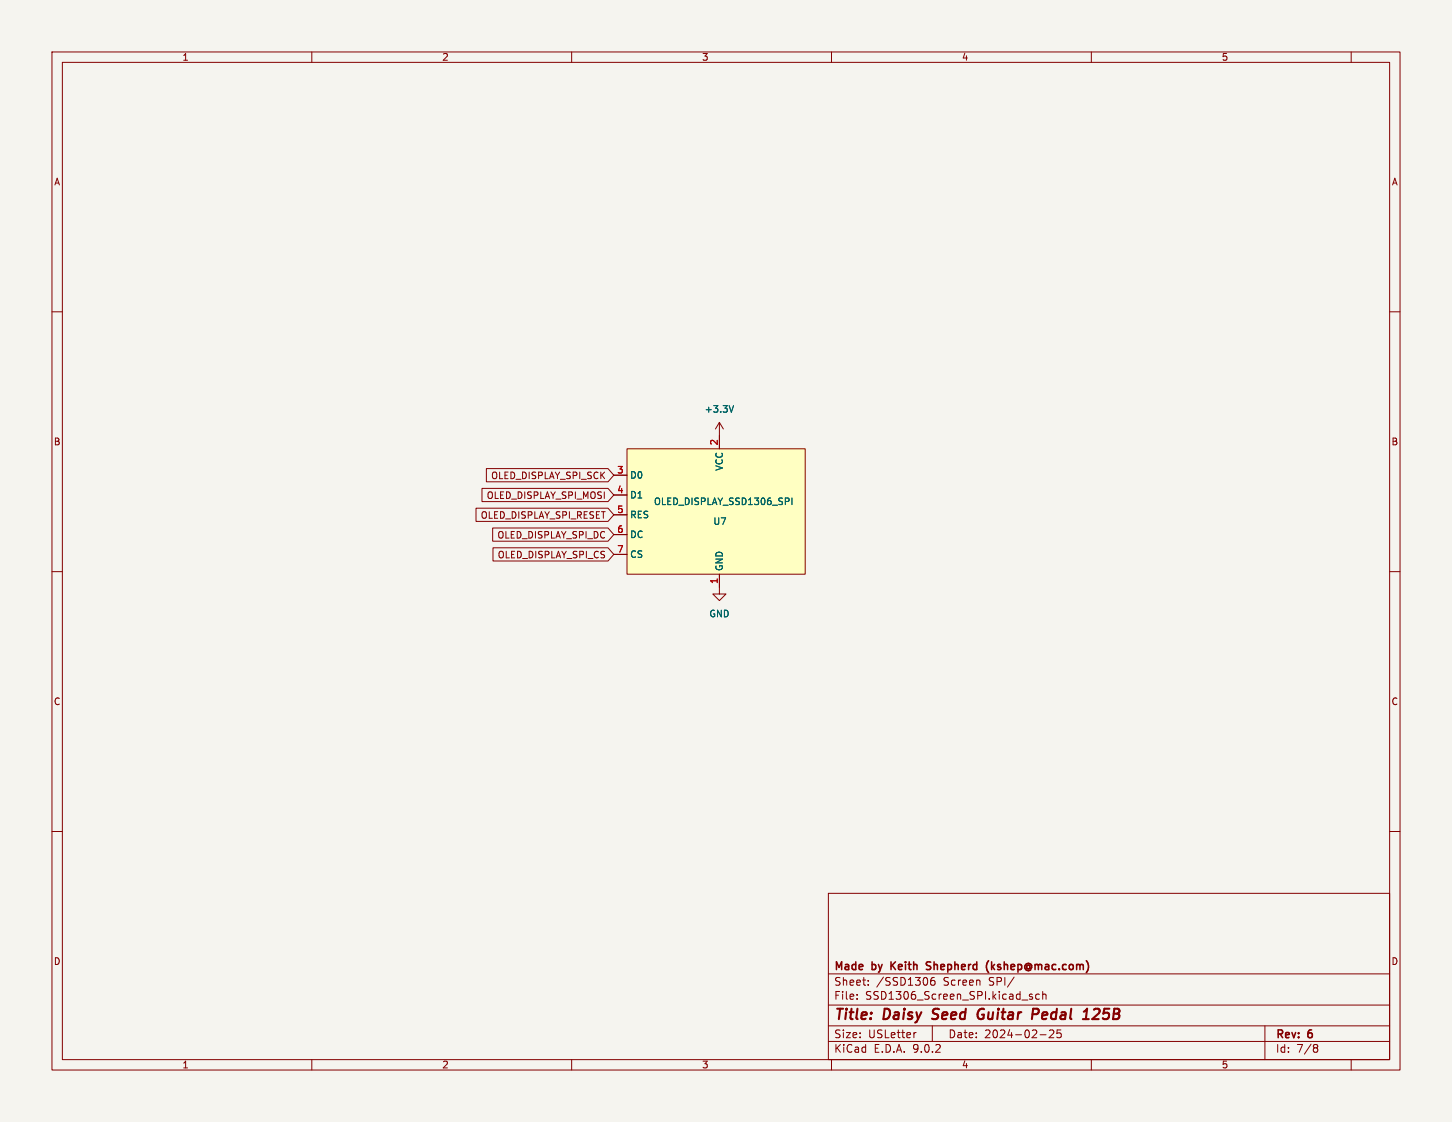
[picture p19: page 7]

Id: 7/8 Title: Daisy Seed Guitar Pedal 125B

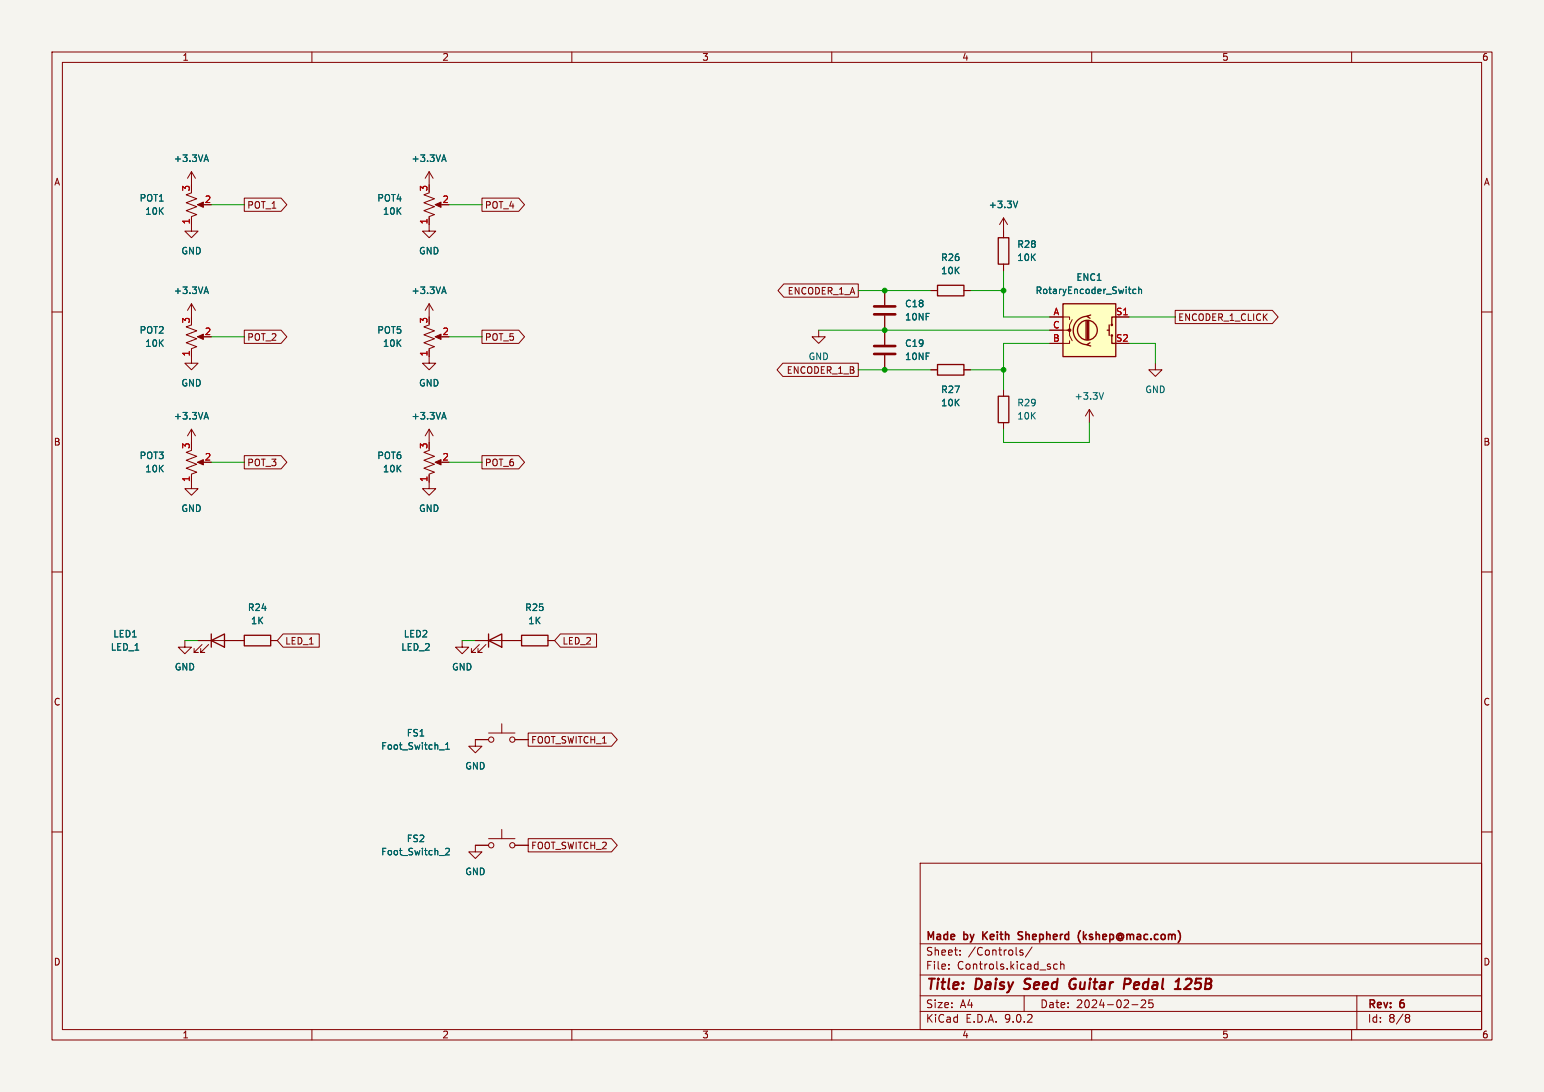
[picture p20: page 8]

Id: 8/8 Title: Daisy Seed Guitar Pedal 125B
