wjwpoi/DaisySeedProjects/SeedFX/hardware/manufacturing/adapter/assembly.pdf

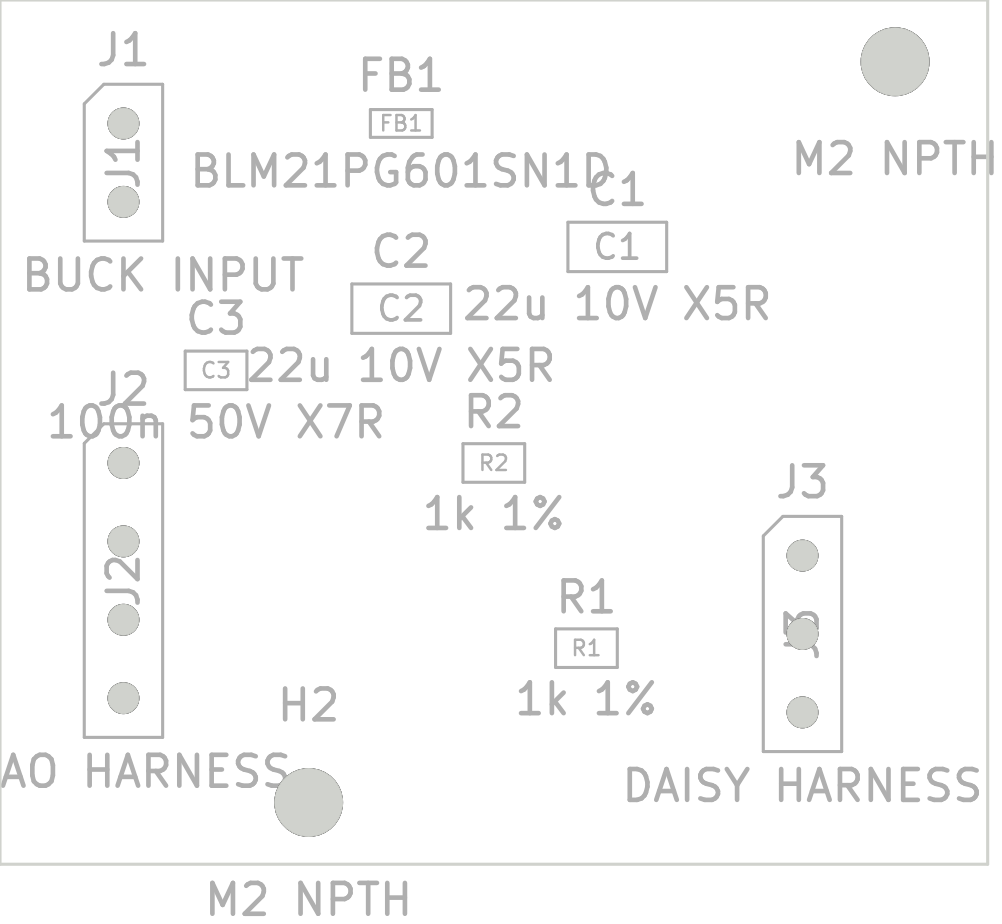
[picture p21: page 1]
