wjwpoi/DaisySeedProjects/SeedFX/hardware/manufacturing/adapter/schematic.pdf

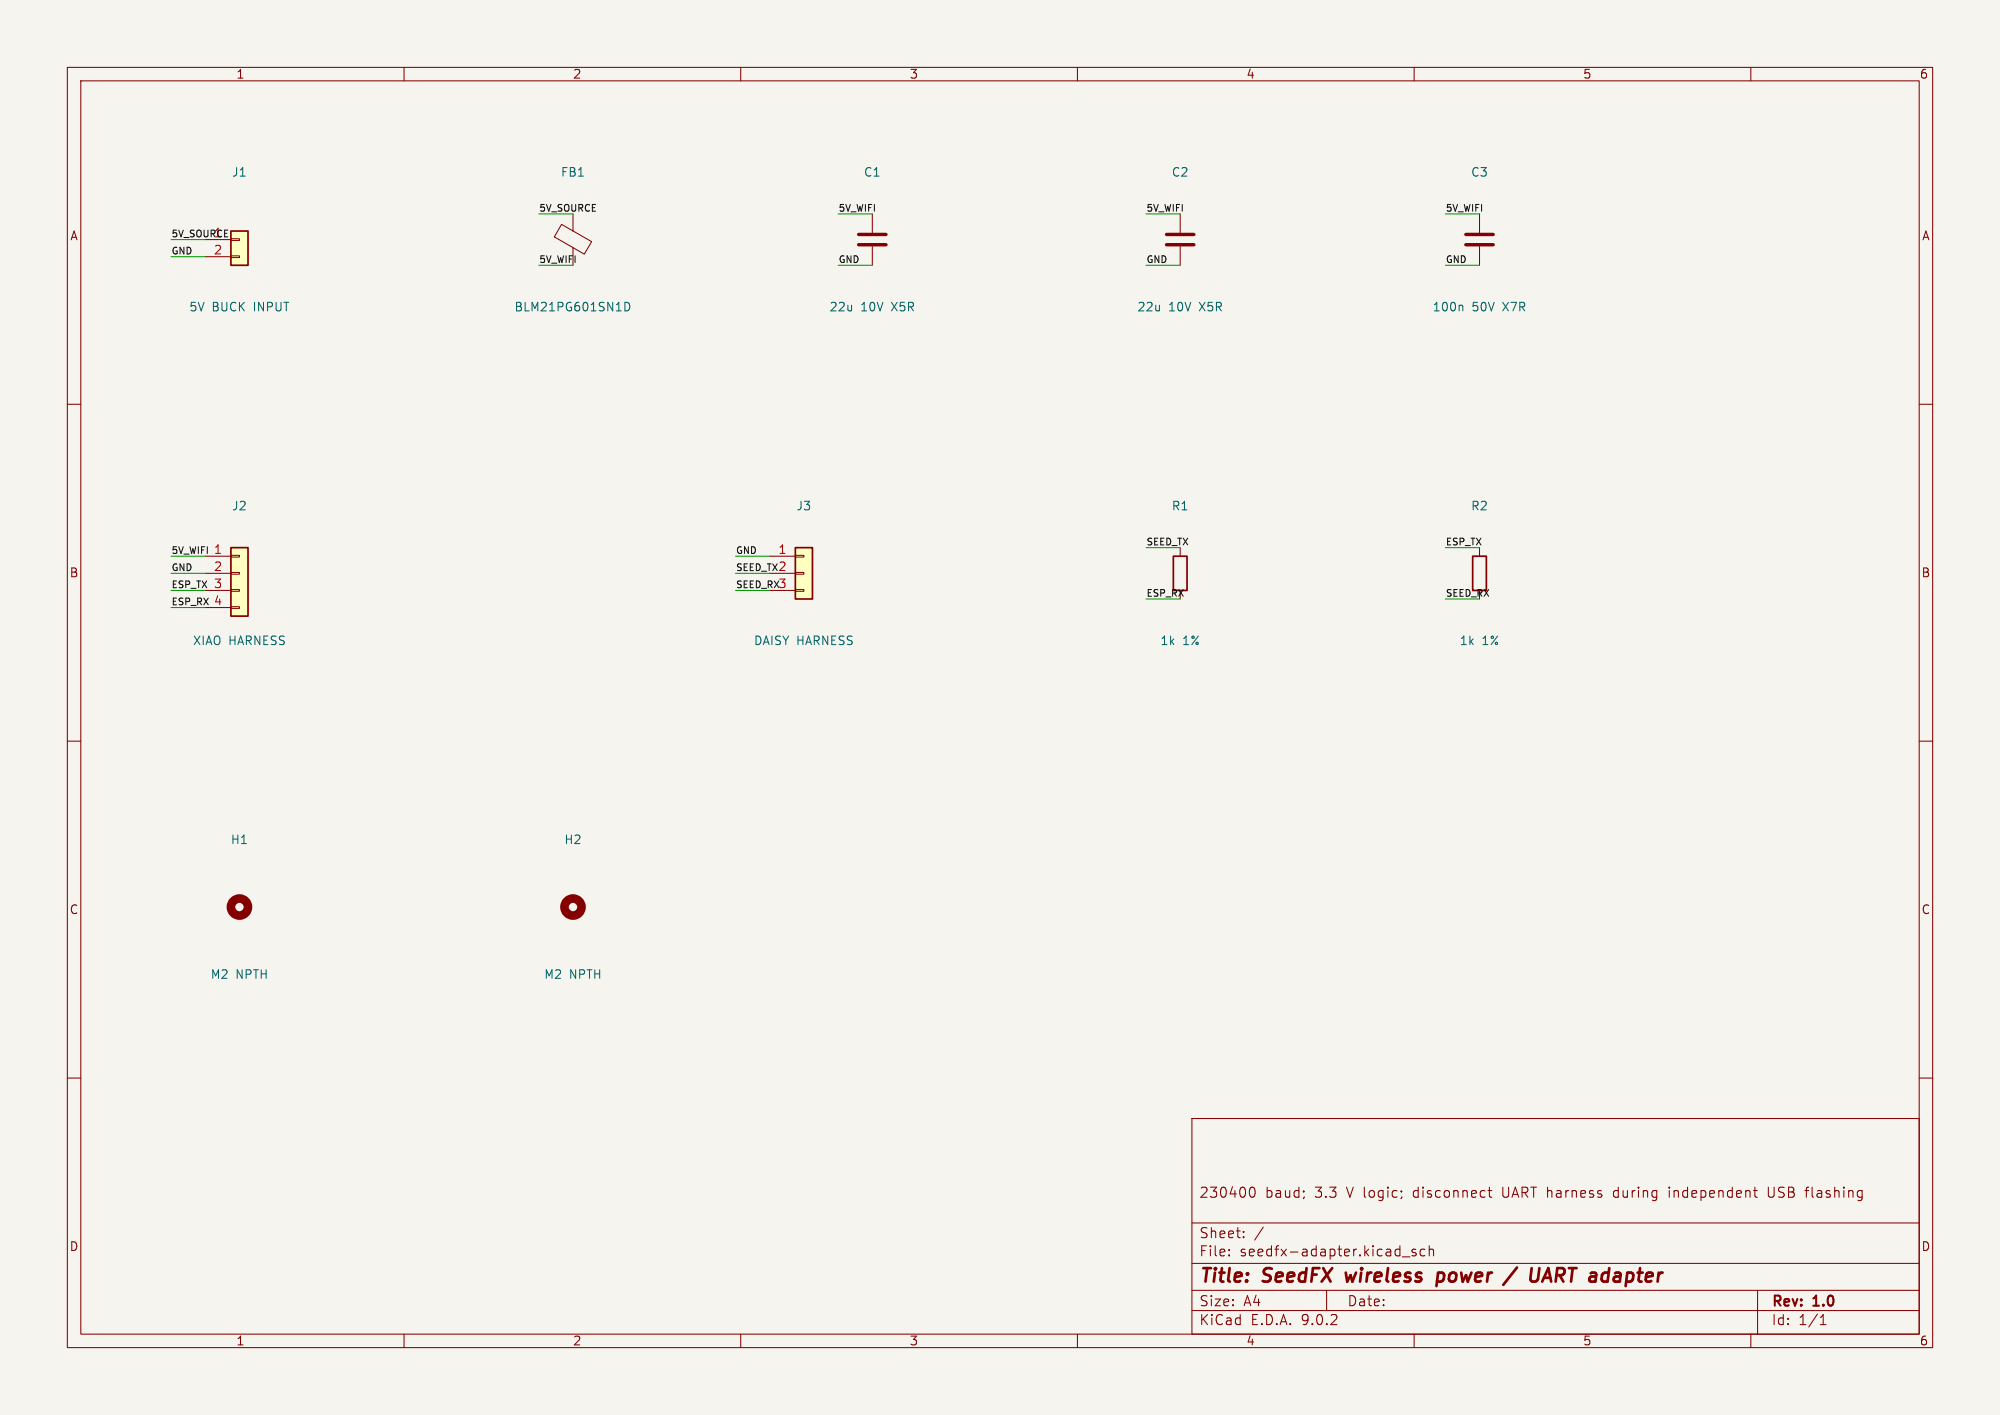
[picture p22: page 1]
