wjwpoi/DaisySeedProjects/SeedFX/hardware/manufacturing/mainboard/assembly.pdf

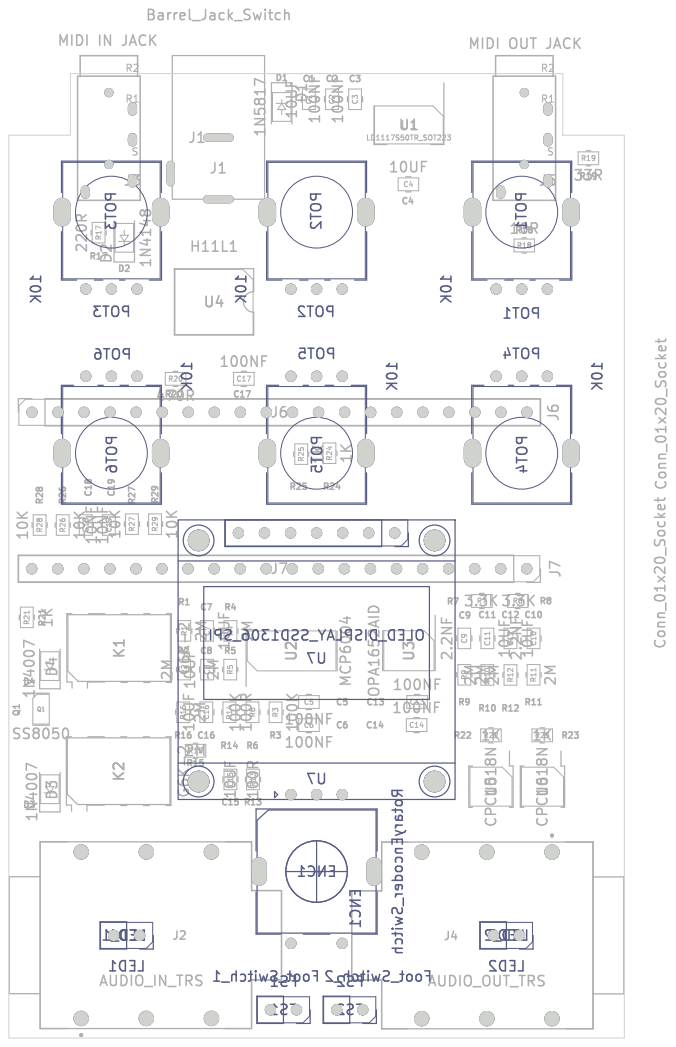
[picture p23: page 1]
