wjwpoi/DaisySeedProjects/SeedFX/hardware/adapter/seedfx-adapter.kicad_pcb

## KiCad design SeedFX/hardware/adapter/seedfx-adapter.kicad_pcb (2026-10-14)

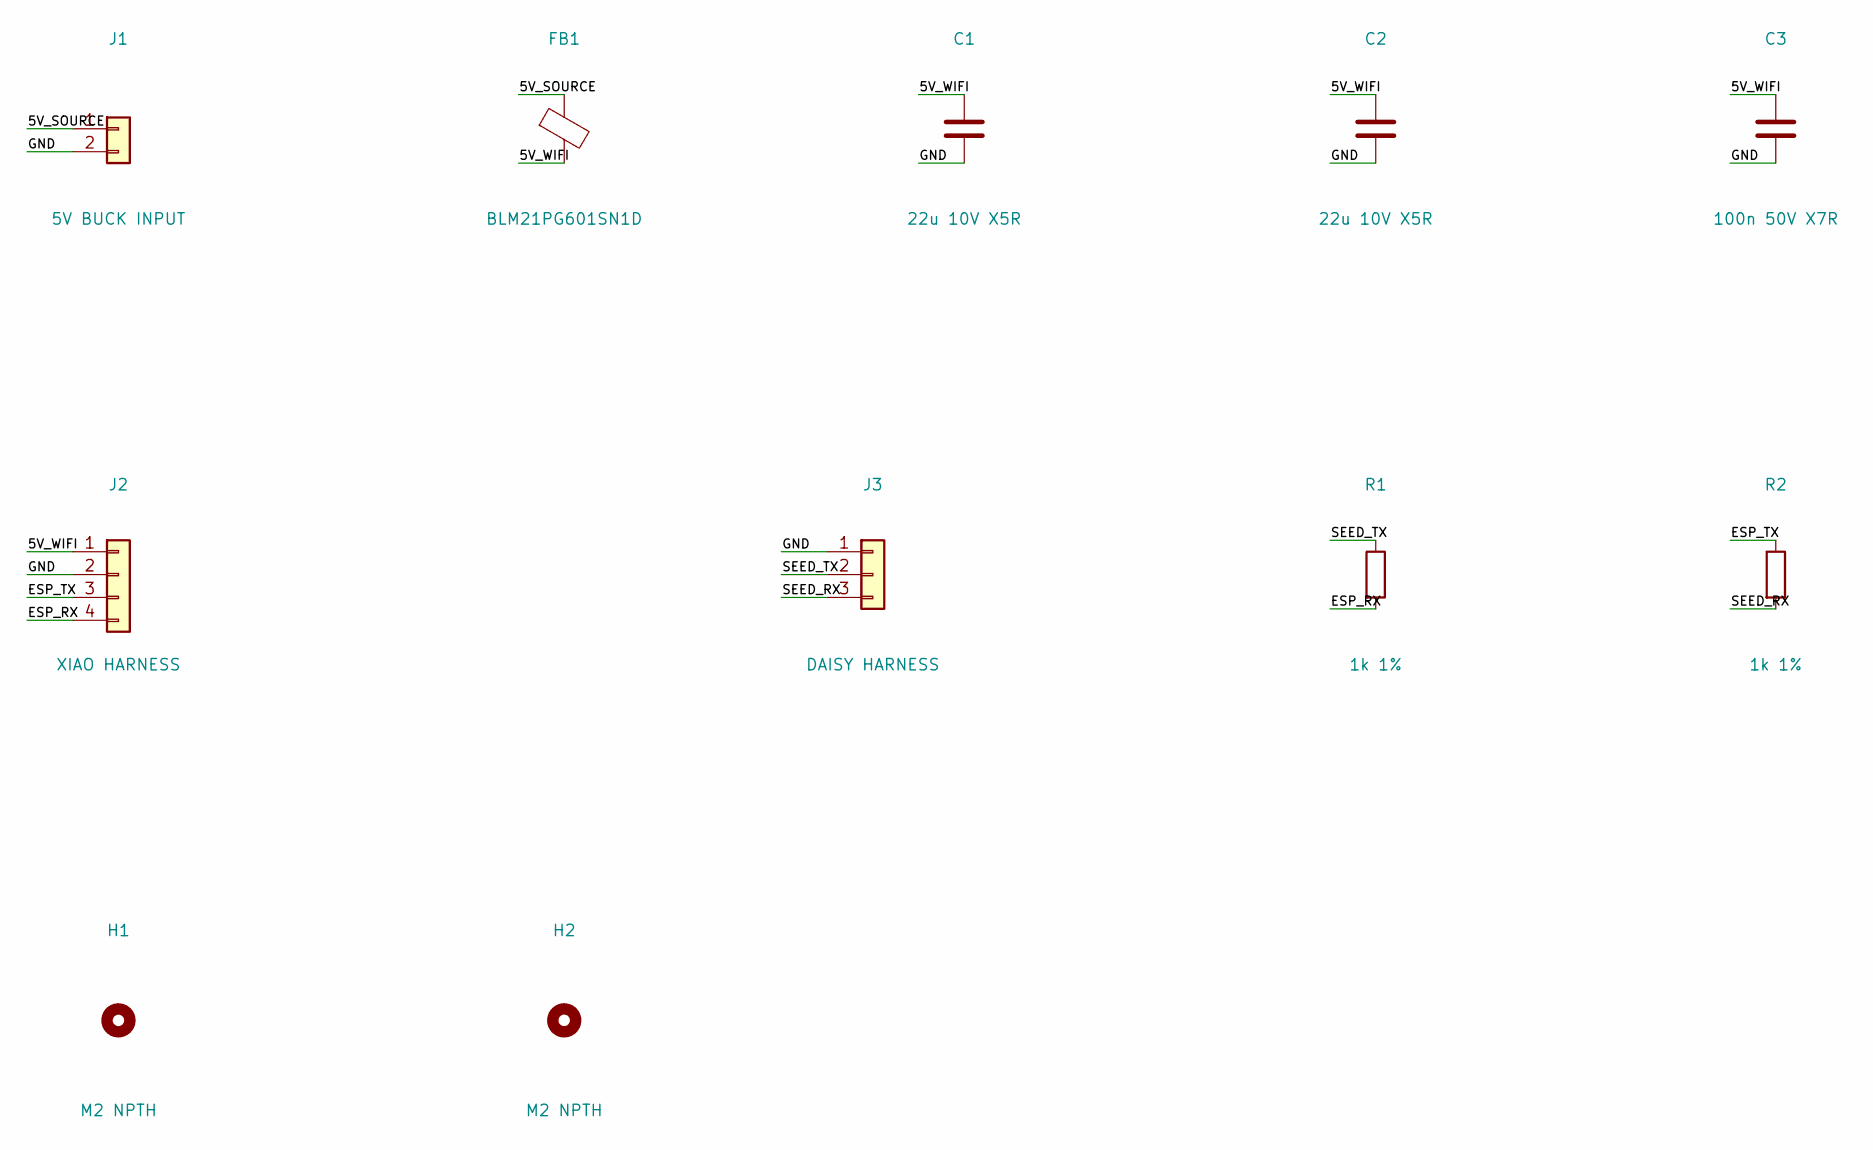
[picture p24: schematic seedfx-adapter.kicad_sch, SeedFX wireless power / UART adapter]

Parts:
C1, C2: 22u 10V X5R; C_1206_3216Metric
C3: 100n 50V X7R; C_0805_2012Metric
FB1: BLM21PG601SN1D; L_0805_2012Metric
H1, H2: M2 NPTH; MountingHole_2.2mm_M2
J1: 5V BUCK INPUT; PinHeader_1x02_P2.54mm_Vertical
J2: XIAO HARNESS; PinHeader_1x04_P2.54mm_Vertical
J3: DAISY HARNESS; PinHeader_1x03_P2.54mm_Vertical
R1, R2: 1k 1%; R_0805_2012Metric

Connections:
/5V_SOURCE: FB1.1, J1.1
/5V_WIFI: C1.1, C2.1, C3.1, FB1.2, J2.1
/ESP_RX: J2.4, R1.2
/ESP_TX: J2.3, R2.1
/GND: C1.2, C2.2, C3.2, J1.2, J2.2, J3.1
/SEED_RX: J3.3, R2.2
/SEED_TX: J3.2, R1.1

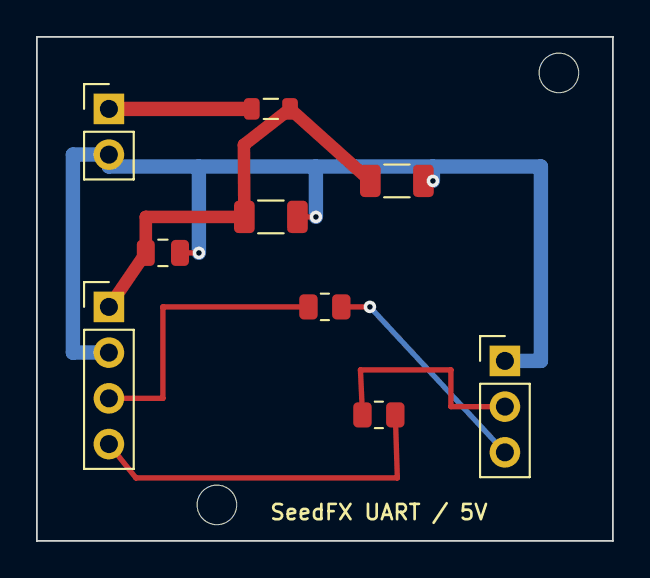
[picture p25: board seedfx-adapter.kicad_pcb from above]

Board: 2 copper layers, 32.0 x 28.0 mm, 11 parts (0 on the bottom side), 7 nets.
