wjwpoi/DaisySeedProjects/SeedFX/hardware/mainboard/DaisySeedPedal125b.kicad_pcb

## KiCad design SeedFX/hardware/mainboard/DaisySeedPedal125b.kicad_pcb (2026-10-14)

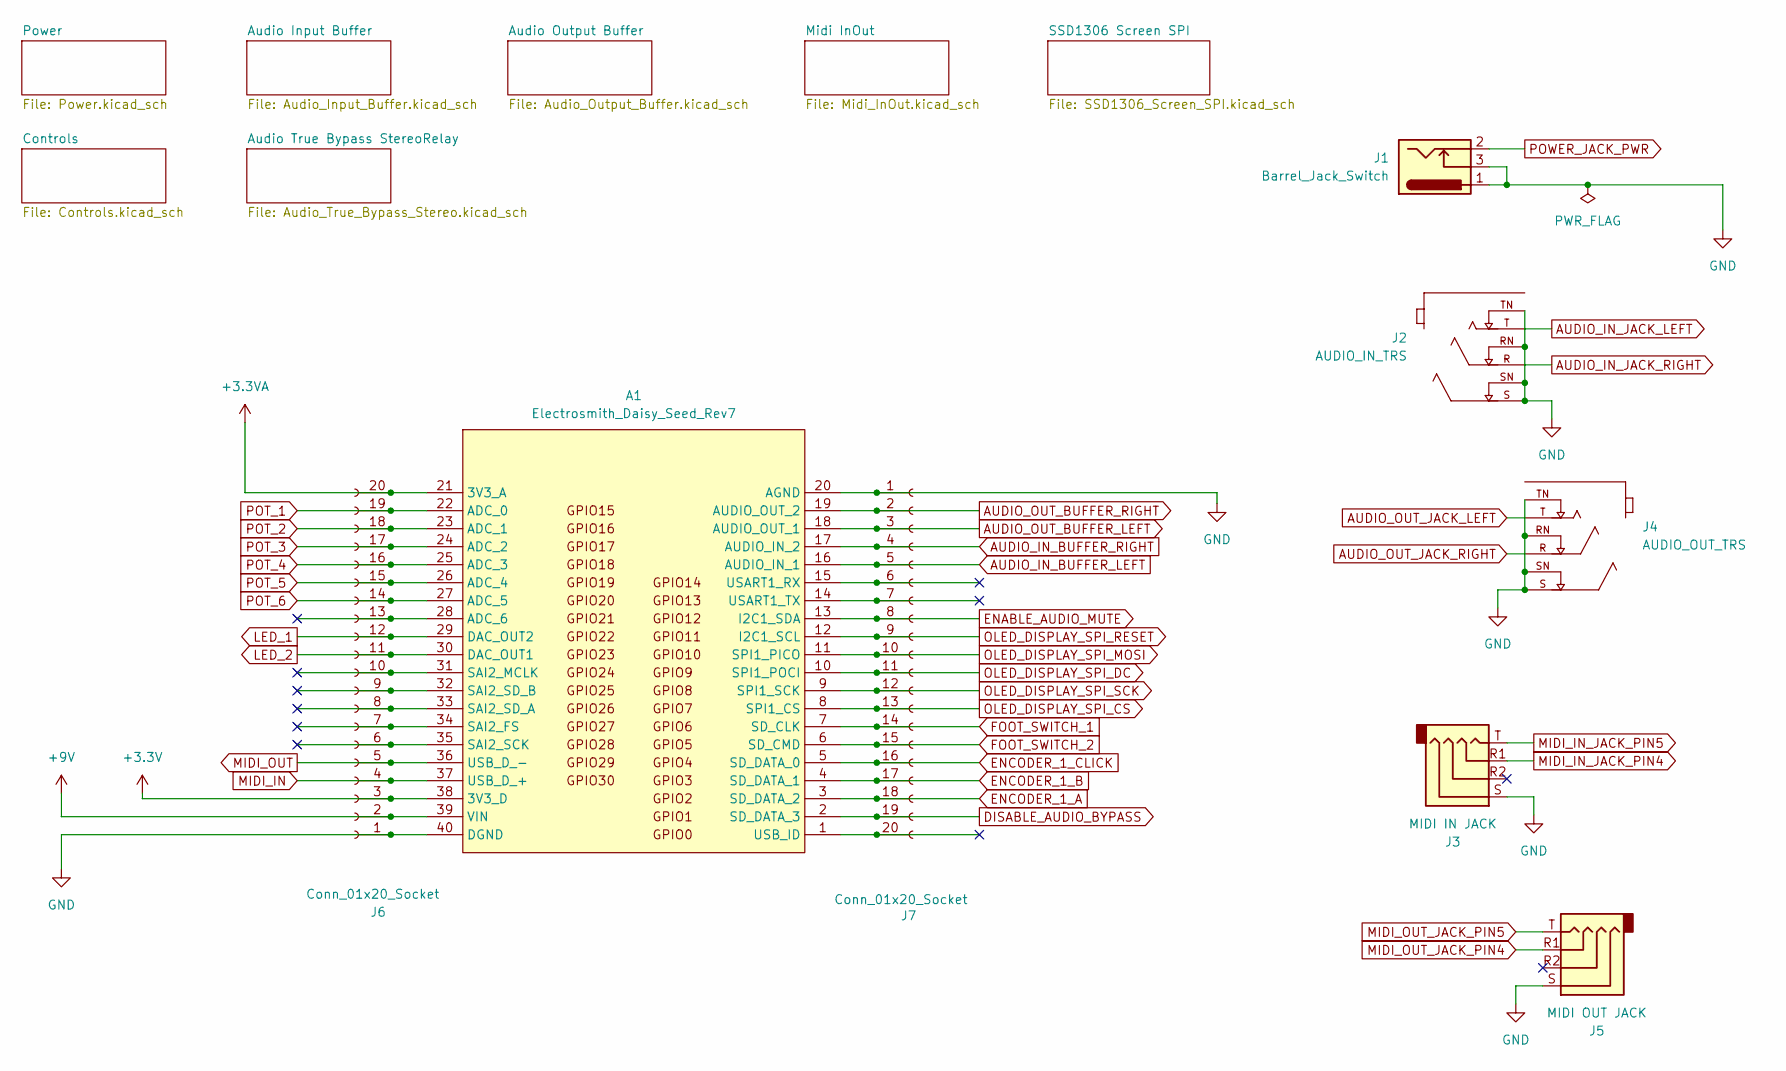
[picture p26: schematic DaisySeedPedal125b.kicad_sch, Daisy Seed Guitar Pedal 125B]

Parts:
A1: Electrosmith_Daisy_Seed_Rev7
J1: Barrel_Jack_Switch; Generic_PowerJack
J2: AUDIO_IN_TRS; NEUTRIK_NMJ6HCD2; PARTREV 26.02.2021
J3: MIDI IN JACK; PJ-320A
J4: AUDIO_OUT_TRS; NEUTRIK_NMJ6HCD2; PARTREV 26.02.2021
J5: MIDI OUT JACK; PJ-320A
J6, J7: Conn_01x20_Socket; PinSocket1x20_P2.54mm_Vertical_JLCPCB

Connections:
+3.3V: A1.38 (3V3_D), J6.3; also elsewhere on the board
+3.3VA: A1.21 (3V3_A), J6.20; also elsewhere on the board
+9V: A1.39 (VIN), J6.2; also elsewhere on the board
AUDIO_IN_BUFFER_LEFT: A1.16 (AUDIO_IN_1), J7.5; also elsewhere on the board
AUDIO_IN_BUFFER_RIGHT: A1.17 (AUDIO_IN_2), J7.4; also elsewhere on the board
AUDIO_IN_JACK_LEFT: J2.T; also elsewhere on the board
AUDIO_IN_JACK_RIGHT: J2.R; also elsewhere on the board
AUDIO_OUT_BUFFER_LEFT: A1.18 (AUDIO_OUT_1), J7.3; also elsewhere on the board
AUDIO_OUT_BUFFER_RIGHT: A1.19 (AUDIO_OUT_2), J7.2; also elsewhere on the board
AUDIO_OUT_JACK_LEFT: J4.T; also elsewhere on the board
AUDIO_OUT_JACK_RIGHT: J4.R; also elsewhere on the board
DISABLE_AUDIO_BYPASS: A1.2 (SD_DATA_3), J7.19; also elsewhere on the board
ENABLE_AUDIO_MUTE: A1.13 (I2C1_SDA), J7.8; also elsewhere on the board
ENCODER_1_A: A1.3 (SD_DATA_2), J7.18; also elsewhere on the board
ENCODER_1_B: A1.4 (SD_DATA_1), J7.17; also elsewhere on the board
ENCODER_1_CLICK: A1.5 (SD_DATA_0), J7.16; also elsewhere on the board
FOOT_SWITCH_1: A1.7 (SD_CLK), J7.14; also elsewhere on the board
FOOT_SWITCH_2: A1.6 (SD_CMD), J7.15; also elsewhere on the board
GND: A1.20 (AGND), A1.40 (DGND), J1.1, J1.3, J2.RN, J2.S, J2.SN, J2.TN, J3.S, J4.RN, J4.S, J4.SN, J4.TN, J5.S, J6.1, J7.1; also elsewhere on the board
LED_1: A1.29 (DAC_OUT2), J6.12; also elsewhere on the board
LED_2: A1.30 (DAC_OUT1), J6.11; also elsewhere on the board
MIDI_IN: A1.37 (USB_D_+), J6.4; also elsewhere on the board
MIDI_IN_JACK_PIN4: J3.R1; also elsewhere on the board
MIDI_IN_JACK_PIN5: J3.T; also elsewhere on the board
MIDI_OUT: A1.36 (USB_D_-), J6.5; also elsewhere on the board
MIDI_OUT_JACK_PIN4: J5.R1; also elsewhere on the board
MIDI_OUT_JACK_PIN5: J5.T; also elsewhere on the board
unnamed: A1.1 (USB_ID), J7.20
unnamed: A1.14 (USART1_TX), J7.7
unnamed: A1.15 (USART1_RX), J7.6
unnamed: A1.28 (ADC_6), J6.13
unnamed: A1.31 (SAI2_MCLK), J6.10
unnamed: A1.32 (SAI2_SD_B), J6.9
unnamed: A1.33 (SAI2_SD_A), J6.8
unnamed: A1.34 (SAI2_FS), J6.7
unnamed: A1.35 (SAI2_SCK), J6.6
OLED_DISPLAY_SPI_CS: A1.8 (SPI1_CS), J7.13; also elsewhere on the board
OLED_DISPLAY_SPI_DC: A1.10 (SPI1_POCI), J7.11; also elsewhere on the board
OLED_DISPLAY_SPI_MOSI: A1.11 (SPI1_PICO), J7.10; also elsewhere on the board
OLED_DISPLAY_SPI_RESET: A1.12 (I2C1_SCL), J7.9; also elsewhere on the board
OLED_DISPLAY_SPI_SCK: A1.9 (SPI1_SCK), J7.12; also elsewhere on the board
POT_1: A1.22 (ADC_0), J6.19; also elsewhere on the board
POT_2: A1.23 (ADC_1), J6.18; also elsewhere on the board
POT_3: A1.24 (ADC_2), J6.17; also elsewhere on the board
POT_4: A1.25 (ADC_3), J6.16; also elsewhere on the board
POT_5: A1.26 (ADC_4), J6.15; also elsewhere on the board
POT_6: A1.27 (ADC_5), J6.14; also elsewhere on the board
POWER_JACK_PWR: J1.2; also elsewhere on the board

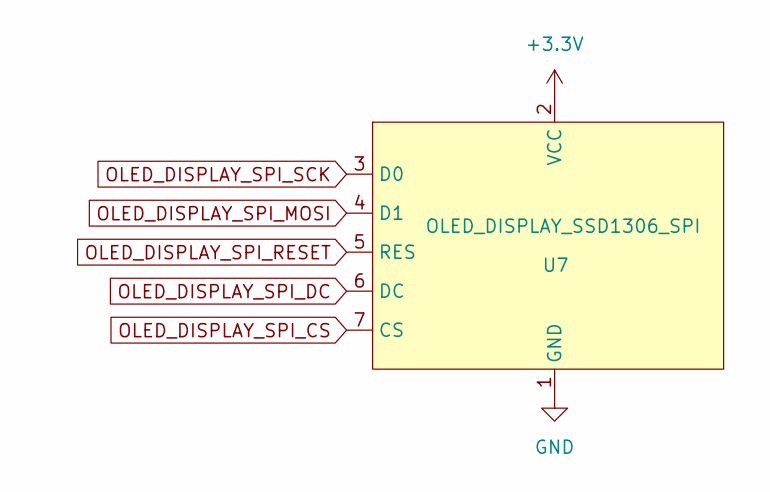
[picture p27: schematic SSD1306_Screen_SPI.kicad_sch, Daisy Seed Guitar Pedal 125B]

Parts:
U7: OLED_DISPLAY_SSD1306_SPI; HiLetgo_OLED_SPI

Connections:
+3.3V: U7.2 (VCC); also elsewhere on the board
GND: U7.1 (GND); also elsewhere on the board
OLED_DISPLAY_SPI_CS: U7.7 (CS); also elsewhere on the board
OLED_DISPLAY_SPI_DC: U7.6 (DC); also elsewhere on the board
OLED_DISPLAY_SPI_MOSI: U7.4 (D1); also elsewhere on the board
OLED_DISPLAY_SPI_RESET: U7.5 (RES); also elsewhere on the board
OLED_DISPLAY_SPI_SCK: U7.3 (D0); also elsewhere on the board

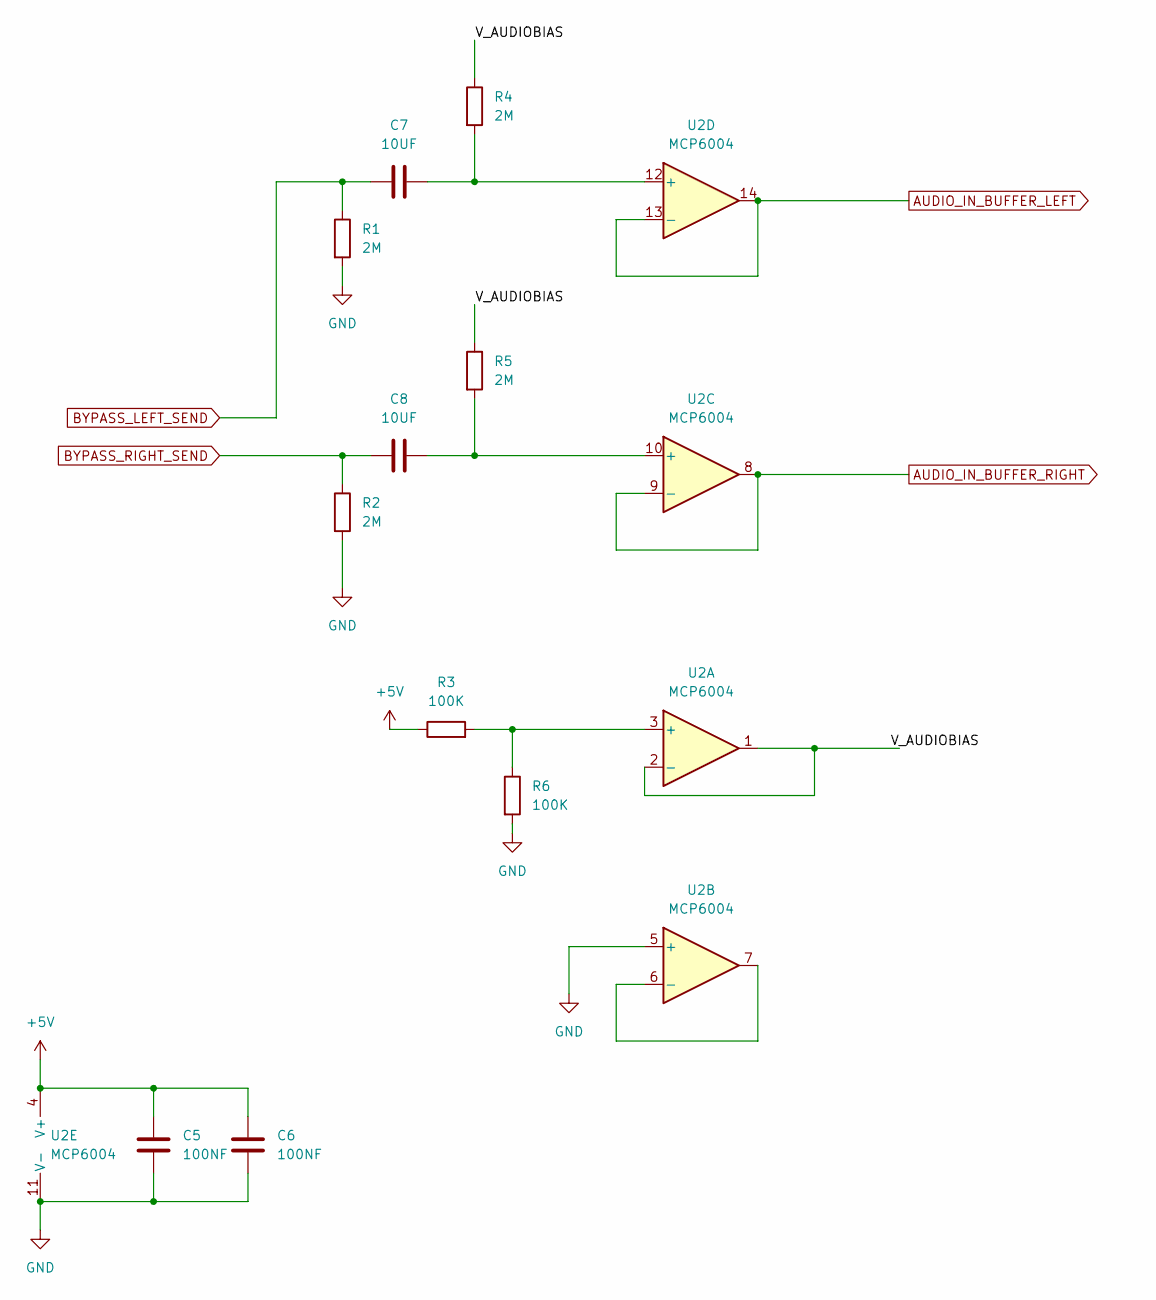
[picture p28: schematic Audio_Input_Buffer.kicad_sch, Daisy Seed Guitar Pedal 125B]

Parts:
C5, C6: 100NF; C_0805_2012Metric
C7, C8: 10UF; C_0805_2012Metric
R1, R2, R4, R5: 2M; R_0805_2012Metric
R3, R6: 100K; R_0805_2012Metric
U2: MCP6004; SOIC-14_3.9x8.7mm_P1.27mm

Connections:
+5V: C5.1, C6.1, R3.1, U2.4 (V+); also elsewhere on the board
/Audio Input Buffer/V_AUDIOBIAS: R4.1, R5.1, U2.1, U2.2 (-)
AUDIO_IN_BUFFER_LEFT: U2.13 (-), U2.14; also elsewhere on the board
AUDIO_IN_BUFFER_RIGHT: U2.8, U2.9 (-); also elsewhere on the board
BYPASS_LEFT_SEND: C7.1, R1.1; also elsewhere on the board
BYPASS_RIGHT_SEND: C8.1, R2.1; also elsewhere on the board
GND: C5.2, C6.2, R1.2, R2.2, R6.2, U2.5 (+), U2.11 (V-); also elsewhere on the board
unnamed: R3.2, R6.1, U2.3 (+)
unnamed: U2.6 (-), U2.7
unnamed: C8.2, R5.2, U2.10 (+)
unnamed: C7.2, R4.2, U2.12 (+)

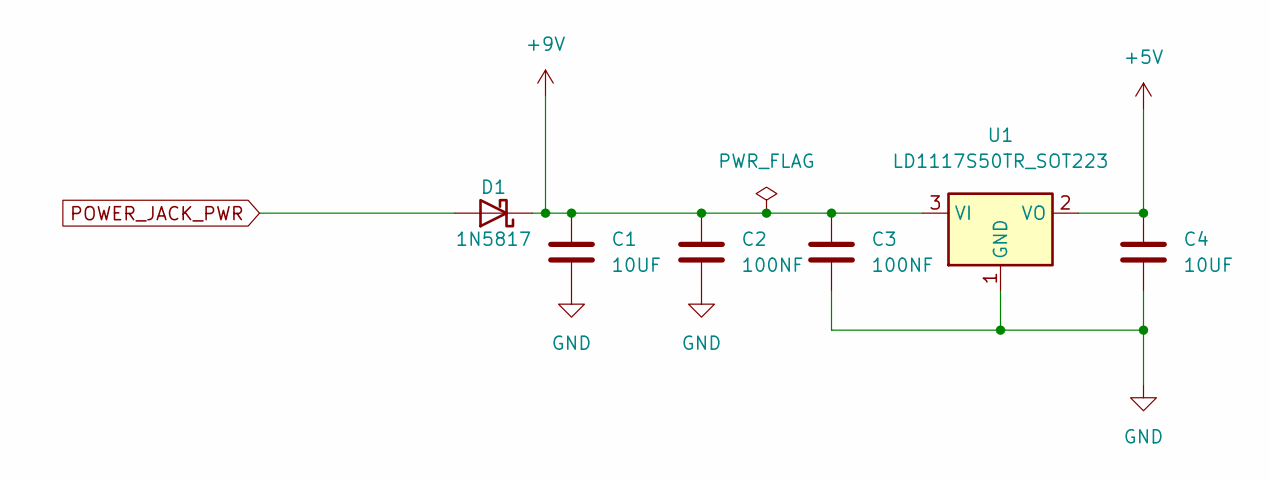
[picture p29: schematic Power.kicad_sch, Daisy Seed Guitar Pedal 125B]

Parts:
C1, C4: 10UF; C_0805_2012Metric
C2, C3: 100NF; C_0805_2012Metric
D1: 1N5817; D_SOD-123
U1: LD1117S50TR_SOT223; SOT-223-3_TabPin2

Connections:
+5V: C4.1, U1.2 (VO); also elsewhere on the board
+9V: C1.1, C2.1, C3.1, D1.1 (K), U1.3 (VI); also elsewhere on the board
GND: C1.2, C2.2, C3.2, C4.2, U1.1 (GND); also elsewhere on the board
POWER_JACK_PWR: D1.2 (A); also elsewhere on the board

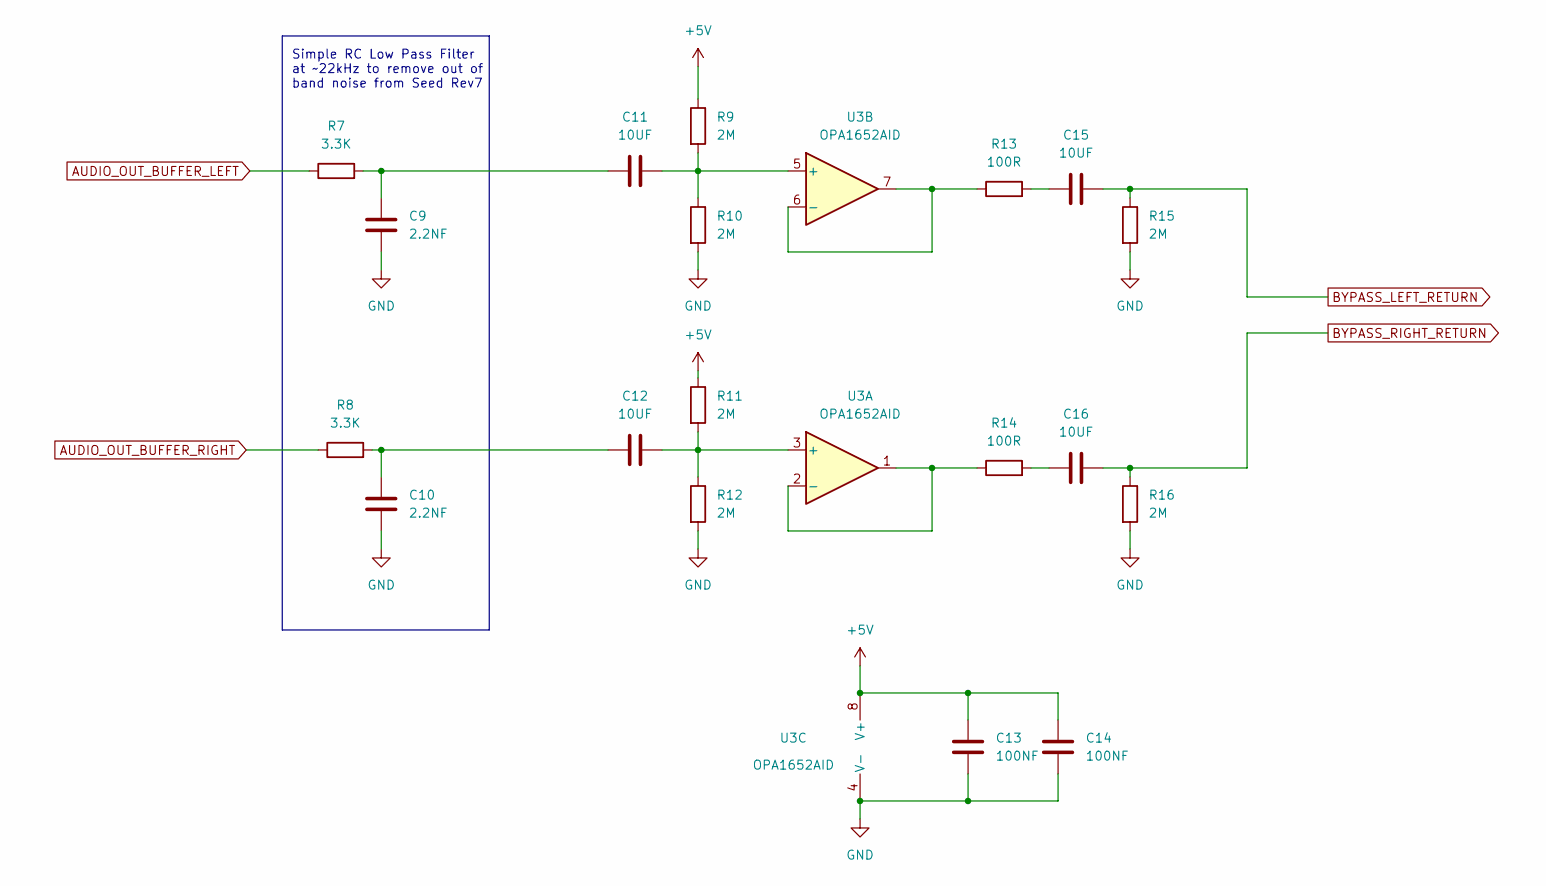
[picture p30: schematic Audio_Output_Buffer.kicad_sch, Daisy Seed Guitar Pedal 125B]

Parts:
C9, C10: 2.2NF; C_0805_2012Metric
C11, C12, C15, C16: 10UF; C_0805_2012Metric
C13, C14: 100NF; C_0805_2012Metric
R7, R8: 3.3K; R_0805_2012Metric
R9, R10, R11, R12, R15, R16: 2M; R_0805_2012Metric
R13, R14: 100R; R_0805_2012Metric
U3: OPA1652AID; SOIC-8_3.9x4.9mm_P1.27mm

Connections:
+5V: C13.1, C14.1, R9.1, R11.1, U3.8 (V+); also elsewhere on the board
AUDIO_OUT_BUFFER_LEFT: R7.1; also elsewhere on the board
AUDIO_OUT_BUFFER_RIGHT: R8.1; also elsewhere on the board
BYPASS_LEFT_RETURN: C15.2, R15.1; also elsewhere on the board
BYPASS_RIGHT_RETURN: C16.2, R16.1; also elsewhere on the board
GND: C9.2, C10.2, C13.2, C14.2, R10.2, R12.2, R15.2, R16.2, U3.4 (V-); also elsewhere on the board
unnamed: C10.1, C12.2, R8.2
unnamed: C9.1, C11.2, R7.2
unnamed: C15.1, R13.2
unnamed: C16.1, R14.2
unnamed: C12.1, R11.2, R12.1, U3.3 (+)
unnamed: R14.1, U3.1, U3.2 (-)
unnamed: C11.1, R9.2, R10.1, U3.5 (+)
unnamed: R13.1, U3.6 (-), U3.7

Notes on the sheet:
Simple RC Low Pass Filter at ~22kHz to remove out of band noise from Seed Rev7

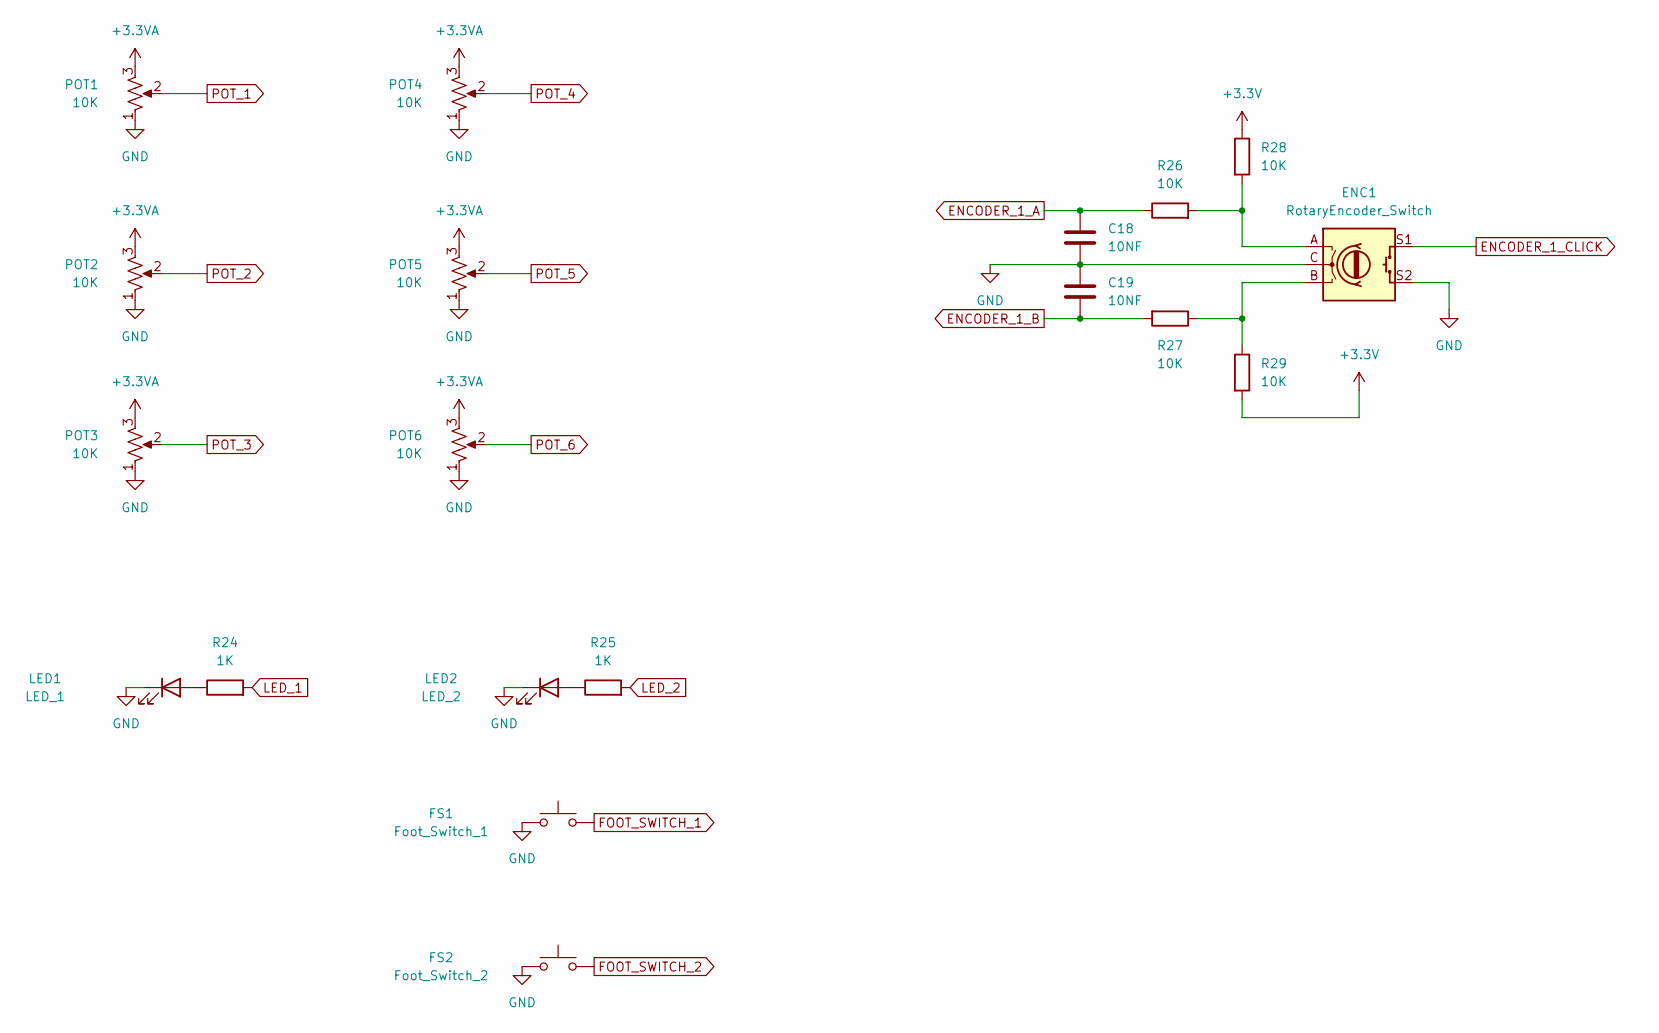
[picture p31: schematic Controls.kicad_sch, Daisy Seed Guitar Pedal 125B]

Parts:
C18, C19: 10NF; C_0805_2012Metric
ENC1: RotaryEncoder_Switch; RotaryEncoder_Alps_EC11E-Switch_Vertical_H20mm
FS1: Foot_Switch_1; PinHeader_1x02_P2.54mm_Vertical
FS2: Foot_Switch_2; PinHeader_1x02_P2.54mm_Vertical
LED1: LED_1; PinHeader_1x02_P2.54mm_Vertical
LED2: LED_2; PinHeader_1x02_P2.54mm_Vertical
POT1, POT2, POT3, POT4, POT5, POT6: 10K; Potentiometer_Bourns_PRS11R
R24, R25: 1K; R_0805_2012Metric
R26, R27, R28, R29: 10K; R_0805_2012Metric

Connections:
+3.3V: R28.1, R29.2; also elsewhere on the board
+3.3VA: POT1.3, POT2.3, POT3.3, POT4.3, POT5.3, POT6.3; also elsewhere on the board
ENCODER_1_A: C18.1, R26.1; also elsewhere on the board
ENCODER_1_B: C19.2, R27.2; also elsewhere on the board
ENCODER_1_CLICK: ENC1.S1; also elsewhere on the board
FOOT_SWITCH_1: FS1.2; also elsewhere on the board
FOOT_SWITCH_2: FS2.2; also elsewhere on the board
GND: C18.2, C19.1, ENC1.C, ENC1.S2, FS1.1, FS2.1, LED1.1 (K), LED2.1 (K), POT1.1, POT2.1, POT3.1, POT4.1, POT5.1, POT6.1; also elsewhere on the board
LED_1: R24.2; also elsewhere on the board
LED_2: R25.2; also elsewhere on the board
unnamed: ENC1.A, R26.2, R28.2
unnamed: ENC1.B, R27.1, R29.1
unnamed: LED1.2 (A), R24.1
unnamed: LED2.2 (A), R25.1
POT_1: POT1.2; also elsewhere on the board
POT_2: POT2.2; also elsewhere on the board
POT_3: POT3.2; also elsewhere on the board
POT_4: POT4.2; also elsewhere on the board
POT_5: POT5.2; also elsewhere on the board
POT_6: POT6.2; also elsewhere on the board

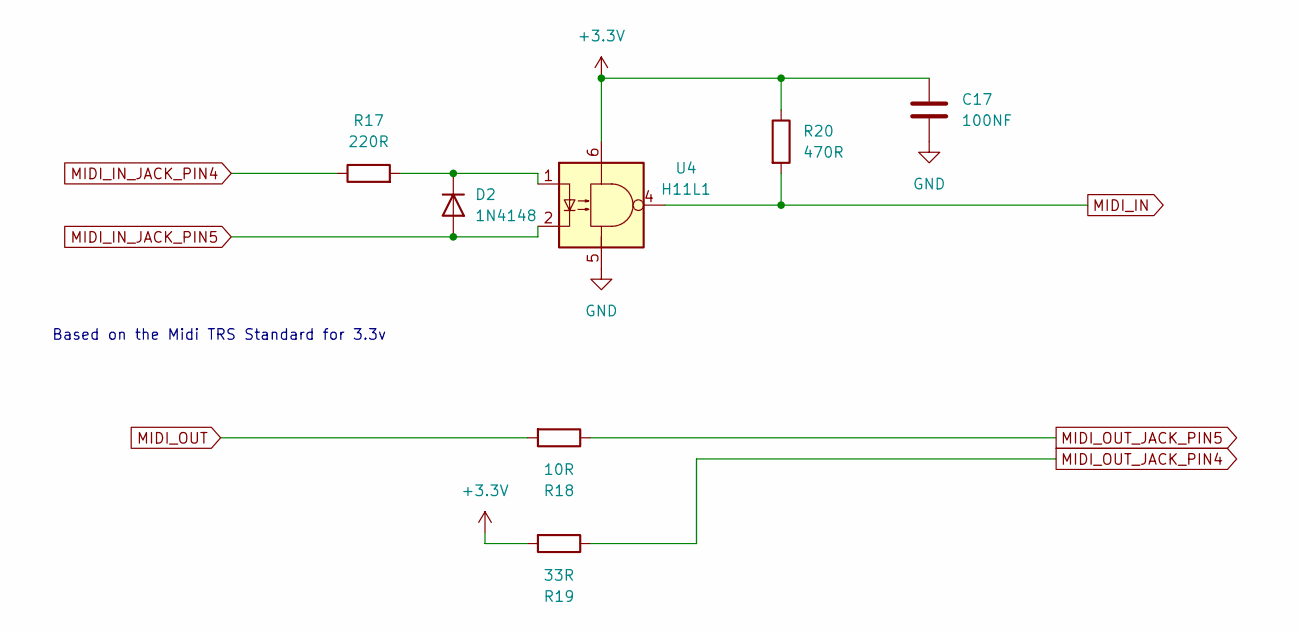
[picture p32: schematic Midi_InOut.kicad_sch, Daisy Seed Guitar Pedal 125B]

Parts:
C17: 100NF; C_0805_2012Metric
D2: 1N4148; D_SOD-123
R17: 220R; R_0805_2012Metric
R18: 10R; R_0805_2012Metric
R19: 33R; R_0805_2012Metric
R20: 470R; R_0805_2012Metric
U4: H11L1; SOP-6_2.54mm

Connections:
+3.3V: C17.1, R19.2, R20.1, U4.6; also elsewhere on the board
GND: C17.2, U4.5; also elsewhere on the board
MIDI_IN: R20.2, U4.4; also elsewhere on the board
MIDI_IN_JACK_PIN4: R17.1; also elsewhere on the board
MIDI_IN_JACK_PIN5: D2.2 (A), U4.2; also elsewhere on the board
MIDI_OUT: R18.2; also elsewhere on the board
MIDI_OUT_JACK_PIN4: R19.1; also elsewhere on the board
MIDI_OUT_JACK_PIN5: R18.1; also elsewhere on the board
unnamed: D2.1 (K), R17.2, U4.1

Notes on the sheet:
Based on the Midi TRS Standard for 3.3v

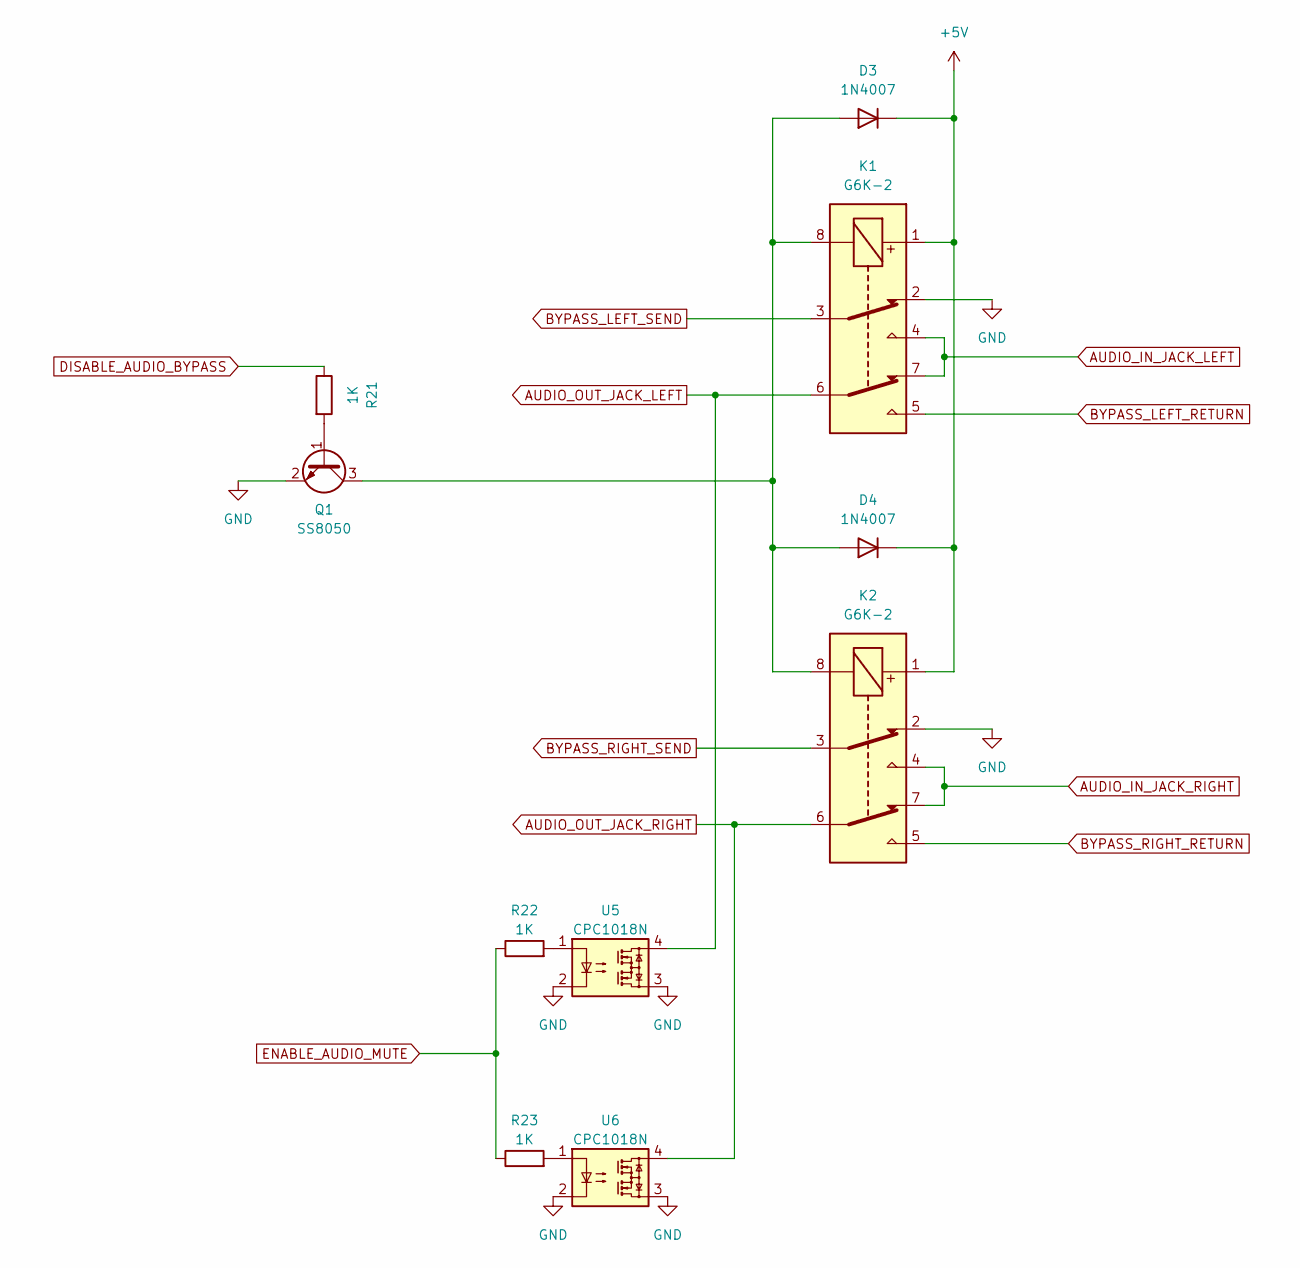
[picture p33: schematic Audio_True_Bypass_Stereo.kicad_sch, Daisy Seed Guitar Pedal 125B]

Parts:
D3, D4: 1N4007; D_SOD-123F
K1, K2: G6K-2; Relay_DPDT_Omron_G6K-2G-Y
Q1: SS8050; SOT-23-3
R21, R22, R23: 1K; R_0805_2012Metric
U5, U6: CPC1018N; SOP-4_3.8x4.1mm_P2.54mm

Connections:
+5V: D3.1 (K), D4.1 (K), K1.1, K2.1; also elsewhere on the board
AUDIO_IN_JACK_LEFT: K1.4, K1.7; also elsewhere on the board
AUDIO_IN_JACK_RIGHT: K2.4, K2.7; also elsewhere on the board
AUDIO_OUT_JACK_LEFT: K1.6, U5.4; also elsewhere on the board
AUDIO_OUT_JACK_RIGHT: K2.6, U6.4; also elsewhere on the board
BYPASS_LEFT_RETURN: K1.5; also elsewhere on the board
BYPASS_LEFT_SEND: K1.3; also elsewhere on the board
BYPASS_RIGHT_RETURN: K2.5; also elsewhere on the board
BYPASS_RIGHT_SEND: K2.3; also elsewhere on the board
DISABLE_AUDIO_BYPASS: R21.1; also elsewhere on the board
ENABLE_AUDIO_MUTE: R22.1, R23.1; also elsewhere on the board
GND: K1.2, K2.2, Q1.2 (E), U5.2, U5.3, U6.2, U6.3; also elsewhere on the board
unnamed: D3.2 (A), D4.2 (A), K1.8, K2.8, Q1.3 (C)
unnamed: Q1.1 (B), R21.2
unnamed: R22.2, U5.1
unnamed: R23.2, U6.1

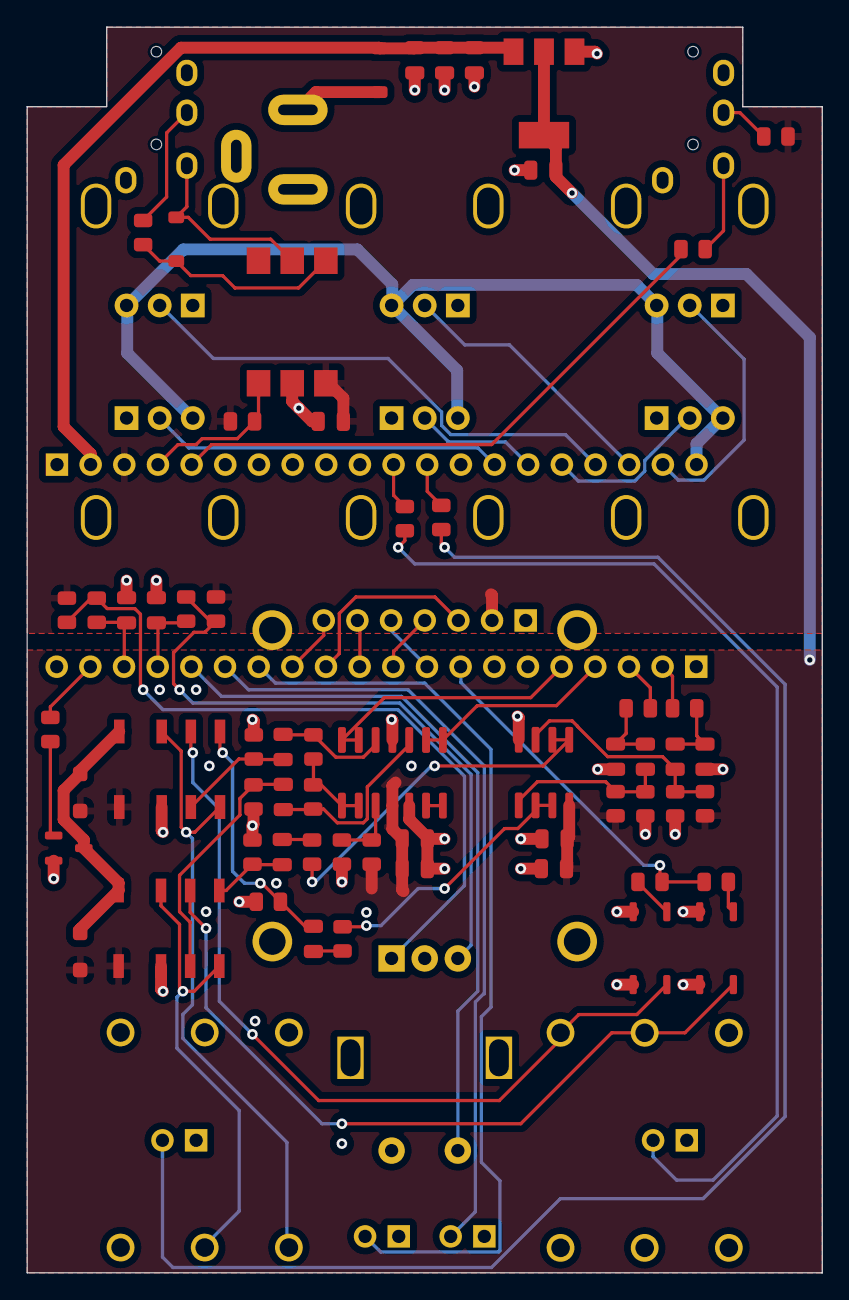
[picture p34: board DaisySeedPedal125b.kicad_pcb from above]

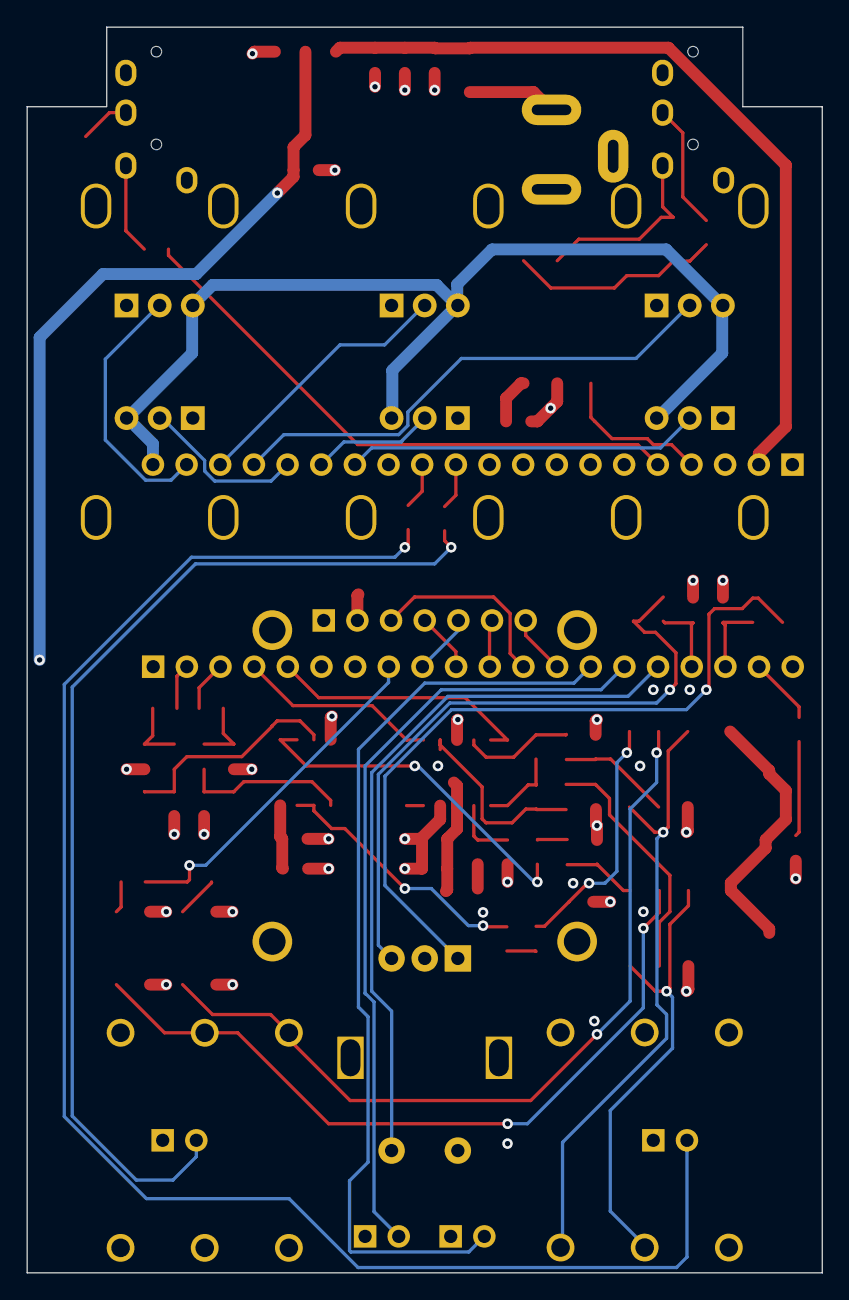
[picture p35: board DaisySeedPedal125b.kicad_pcb from below]

Board: 4 copper layers, 60.0 x 94.0 mm, 80 parts (12 on the bottom side), 66 nets.
