wjwpoi/DaisySeedProjects/(commit log)

2026-10-14 feat(seedfx): add NAM A2 multi-effects platform and engineering package
    Add Daisy audio firmware, ESP32-C3 Wi-Fi control, configurable knob mapping,
    OLED and browser interfaces, presets, and fixed-topology model validation.
    Include PCB projects, fabrication exports, BOM, enclosure CAD, panel artwork,
    verified firmware, release checksums, and build and assembly instructions.
    Preserve generated asset bytes in Git so the release manifest remains valid.
    Validation: ARM and ESP32-C3 builds, 90967 core assertions, 12 Python tests,
    4 JavaScript tests, Chromium checks, ASan/UBSan, PCB DRC, and CAD fit checks.
    Physical audio, timing, power, RF, and supplier fit remain for prototype testing.
    [Audio_Input_Buffer.kicad_sch, Audio_Output_Buffer.kicad_sch, Audio_True_Bypass_Stereo.kicad_sch, Controls.kicad_sch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]
2026-10-14 docs(seedfx): scope build and purchasing to one final device
    Use the same device for bring-up, corrections, enclosure assembly and final
    use. Charge minimum PCB orders and one-time service fees to this project,
    retain spare boards for repairs, and distinguish installed-parts estimates
    from the full unquoted project bill. Refresh the release manifest and package.
    [purchase-bom.csv]
2026-10-14 fix(seedfx): correct procurement geometry and assembly references
    Derive the DC inlet horizontal axis from the Rev6 jack body, correct audio
    input/output side labels, and expand assembly BOM reference ranges with
    explicit quantities checked against the exported KiCad netlist.
    Add PCB-derived mechanical datum checks and publish a procurement readiness
    review. Mark the package as not yet released for full purchasing: complete
    component fit, schematic annotations and supplier quotes still need review.
    Refresh CAD, manufacturing exports, validation logs and release checksums.
    Validation: both firmware builds, 90967 core assertions, 13 Python tests,
    4 JavaScript tests, Chromium, ASan/UBSan, bot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
    [DaisySeedPedal125b-B_Cu.gbl, DaisySeedPedal125b-B_Mask.gbs, DaisySeedPedal125b-B_Paste.gbp, DaisySeedPedal125b-B_Silkscreen.gbo, DaisySeedPedal125b-Edge_Cuts.gm1, DaisySeedPedal125b-F_Cu.gtl, DaisySeedPedal125b-F_Mask.gts, DaisySeedPedal125b-F_Paste.gtp]
2026-10-14 docs(seedfx): price every single-device procurement item and service
    Add purchasing channels, quantities, units and line subtotals to the material
    list. Split adapter materials and headers, DC socket and external supply,
    and separately budget assembly, enclosure machining, shipping and material
    minimum-order allowances. Generate the readable price sheet and update cost
    snapshots and release checksums without claiming live supplier quotations.
    Validation: every line subtotal and both category/project sums checked,
    Python syntax checked, release manifest hashes and documentation links verified.
    [purchase-bom.csv, service-budget.csv]
2026-10-14 docs(seedfx): explain inherited and added single-device costs
    Separate inherited platform materials, Wi-Fi electronics, enclosure extras,
    external power and outsourced service allowances. Cite the reference guide's
    historical five-board PCBA quote without treating it as a current unit price.
    Record cost-reduction candidates as unvalidated alternatives and distinguish
    our planning budget from supplier quotations and commercial retail prices.
2026-10-14 docs(seedfx): budget self-soldering and generic enclosure options
    [diy-budget.csv, tool-budget.csv]
2026-10-15 fix(tonedock): preserve model selection while refreshing library
    [Editor.cpp]
